airpocket-soundman/magfield-nodes/charge-board/README.md

# 充電ボード（ハブ）

ノード基板10台分の充電・監視・書き込みをまとめるボードです。KiCadファイル一式を追加済みですが、**まだ設計途中（WIP）で未発注**です。詳細は [DESIGN.md](DESIGN.md) を参照してください。

## ステータス（2026-10-30時点）

- 4層基板（100 × 96 mm）。現行ファイル（routed70）のDRCは、未接続1件（U2 TCA9535 の VCC）と CH6_STAT ビアのクリアランスエラー4件が残っています。
- U2周りの局部改版は試行済みですが、最良案は採用せず現行ファイルのままです。対処方針は DESIGN.md に記録しています。
- `wip/magfield-hub-u2rev19-WIP.kicad_pcb` は、そのU2改版の試行版（設計途中の作業ファイル）です。クリアランスエラーは0件まで解消しましたが、信号の未接続が6件残っており、現行ファイルには未反映です。

## 構成

- ホスト接続: M5Stack の Port A（Grove / I2C）。ボード自体にマイコンは載せない
- 充電チャンネル ×10: MCP73831（PROG抵抗で約40mA = LIR2032の1C）、チャンネルごとのカットオフ用MOSFETとステータスLED
- 制御・監視: TCA9535（I2C GPIOエクスパンダ）×2 でカットオフ制御とSTAT読み取り、74HC4067（アナログマルチプレクサ）+ ADS1115（I2C ADC）で全チャンネルの電池電圧を読み取り
  - 「充電を一瞬止めてから電圧を測る」ことで、80〜90%充電でのカットオフを電圧ベースで判定する
- 書き込み: UPDI入力を同様に切り替えて、選択したチャンネルのノードへ書き込み信号を送る
- 電源: 充電用5VはボードのUSB-C入力から（10ch合計約400mAのため、Port Aの5Vには頼らない）
- ノード接続: JST PH 4ピン ×10（1=GND / 2=VBAT充電 / 3=UPDI / 4=ID予備）— ノード基板側と同一の割り当て

## ファイル

- `magfield-hub.kicad_pro / .kicad_sch / .kicad_pcb` — KiCad 8 プロジェクト
- `DESIGN.md` — 設計仕様・判断記録・検証結果
- `hub-bom-jlcpcb.csv` / `hub-cpl-jlcpcb.csv` — JLCPCB PCBA用BOM・配置データ
- `gerbers/` — 製造用ガーバー（4層）
