airpocket-soundman/magfield-nodes/charge-board/DESIGN.md

# MAGFIELD HUB — M5Stack制御 10ch充電ボード 設計メモ

磁場可視化ノード（`../kicad/`、ノード基板v2 = JST PH 4pin仕様）の充電・書き込みハブ。
旧STM32ドック（`../kicad-dock/`）の後継で、頭脳は持たず、制御は Port A (Grove/I2C) で
接続した M5Stack が担う。チャンネル回路のレシピはドック設計を踏襲。

**状態: 100×96mm 版（2026-10-30 レイアウト変更＋仕上げ配線、同日に4層化して
プレーン接続化）。未接続は 23→**1項目**（U2.21 VCC のみ、下記「検証結果」に
理由と対処を明記）まで削減。DRC エラーは CH6_STAT ビア1箇所の4件のみ
（クリアランス 0.175mm／ホール 0.20mm、製造可能水準だがルール未達）。
U2.21 は改版か組立時のジャンパ配線で対処すること。それ以外は製造可能水準。**

## ファイル

- `magfield-hub.kicad_pro` / `.kicad_sch` / `.kicad_pcb`
- `maghub.pretty/` — 自作フットプリント（SJ3 ソルダージャンパ）
- `gerbers/` — ガーバー＋ドリル（ゾーン充填済みの最終基板から出力）
- `work/` — 生成スクリプト（design.py が回路の単一情報源、gen_sch.py / gen_pcb.py）、
  配線作業ファイル、`iterations/` — 基板画像

## 基板仕様

- **100 × 96 mm**（2026-10-30 に 118×58 から変更、JLCPCB 最安サイズ帯 ≤100×100 に収納）、
  **4層**、1.6mm想定、JLCPCB標準ルール（クリアランス 0.15mm）
  - 層構成: **F.Cu 信号 / In1.Cu = GND 全面プレーン / In2.Cu = 電源プレーン
    （5V_CHG と 5V_LOG に分割）/ B.Cu 信号**
  - 当初はコスト優先で2層に留めたが、2層では GND/電源ポケットが23項目
    未接続のまま解消できなかったため、2026-10-30 のユーザー判断で本基板のみ
    4層化した（ノード基板は2層のまま）。PROG 24kΩ ≈ 41.7mA の仕様は不変。
- 小型化方針: ノードコネクタは11.35mmピッチ一列では約114mm必要なため、上辺に5個
  （J1〜J5）・下辺に5個（J6〜J10、180°回転）の2列配置に変更。各チャンネルの部品は
  コネクタに隣接するブロックに集約し、制御ICは基板中央の帯（y≈40〜58）に集約して
  信号引き回しを短縮した。
- ゾーン（すべて充填済みで保存）:
  - GND: F.Cu / B.Cu 全面（優先度0）＋ **In1.Cu 全面プレーン（優先度0）**
  - 5V_CHG: B.Cu の上チャンネル領域（y 8.5〜41）＋下チャンネル領域（y 57.5〜88.5）
    ＋左端スパイン（x 2〜16、USB-C/SJ1/C90/C91用、優先度10）
  - 5V_LOG: F.Cu の中央帯（y 31〜61.5、優先度10）— プルアップ抵抗群と制御ICの直上に給電
  - 5V_LOG: B.Cu の中央帯（x 18〜98、y 42〜56.5、優先度10）— 制御ICの直下に給電
    — 制御IC群の直下に給電し、F帯とはビアで接続
  - **In2.Cu 電源プレーン（4層化で追加）**: 5V_CHG = 上/下チャンネル帯
    （y 8.5〜41 / 57.5〜88.5）＋左スパイン（x 2〜16、y 40〜57.5、優先度10）、
    5V_LOG = 中央帯（y 31〜61.5、優先度20で重なり部を優先）。両ネットは
    プレーン上でも分離を維持。浮いていた GND/5V ポケットはビアで各プレーンへ接続した。

## アーキテクチャ

```
M5Stack ──Port A (Grove, I2C 3.3V)── レベルシフト ── I2C (5V) ─┬─ TCA9535 #1 (0x20)
                                                                ├─ TCA9535 #2 (0x21)
                                                                └─ ADS1115 (0x48)
USB-C 5V ── 5V_CHG プレーン ── 10ch充電チャンネル ── JST PH ── ノード
                    └── SJ1（ソルダージャンパ）── 5V_LOG ── ロジック全般
```

- 本基板にメインMCUは無い。全ての制御・計測はM5Stack上のプログラムが行う。
- 充電電力（10ch合計 約400mA）は Port A の5Vに依存せず **USB-C入力** から取る
  （Port A の5V供給能力はM5Stackの機種依存のため）。
- ロジック電源 5V_LOG は SJ1（3パッド・ソルダージャンパ）で選択:
  **デフォルト = 5V_CHG側（USB-C）**、代替 = Grove 5V (GRV_5V)。
  ジャンパ未接続（オープン）だとロジックは無電源になるので、必ずどちらかにブリッジする。
- I2Cレベルシフト: M5Stack Port A は 3.3V ロジック（5Vトレラントでない）ため、
  BSS138 ×2 の定番シフタを入れた。LV側プルアップ(10kΩ)用の 3.3V は
  XC6206P332MR (U91) で 5V_LOG から生成（このLDOの負荷はプルアップのみ）。
  HV側プルアップは 4.7kΩ → 5V_LOG。

## チャンネル回路（×10、ドック設計と同一レシピ）

部品番号は ch n に対して: 受け Jn (J1〜J10)、充電IC U(10+n)、PMOS Q(10+n)、
NMOS Q(20+n)、LED Dn、抵抗は R(100+(n−1)×10 + k) の規則（下表）。

| 役割 | 部品 | 値/型番 | 接続 |
|---|---|---|---|
| ノード接続 | J1〜J10 | JST B4B-PH-K-S | 1=GND, 2=VBAT, 3=UPDI, 4=ID/NC（ノードv2と一致） |
| 充電IC | U11〜U20 | MCP73831T-2ACI/OT (SOT-23-5) | 1=STAT, 2=VSS, 3=VBAT, 4=VDD(5V_CHG), 5=PROG |
| PROG抵抗 | R+1 | 24kΩ | I = 1000/Rprog(kΩ) ≈ 41.7mA ≒ LIR2032の1C（24.9kはBasicでないため24kに変更） |
| 入力容量 | C(50+n) | 4.7µF | 5V_CHG−GND |
| 電池側容量 | C(70+n) | 4.7µF | CHn_BAT−GND |
| カットオフ PMOS | Q(10+n) | AO3401A | S=充電IC側(CHn_CHG), D=ノード側(CHn_BAT) |
| ゲートプルアップ | R+2 | 100kΩ | CHn_BAT − CHn_GATE |
| ゲート駆動 NMOS | Q(20+n) | 2N7002 | ゲート=CHn_EN |
| ENプルアップ | R+3 | 100kΩ | 5V_LOG − CHn_EN |
| STATプルアップ | R+4 | 47kΩ | 5V_LOG − CHn_STAT |
| 状態LED抵抗 | R+5 | 1kΩ | 5V_CHG − LEDアノード |
| 状態LED | D1〜D10 | 0603 赤 | カソード=CHn_STAT（STATがLow=充電中に点灯） |
| VBAT分圧 上 | R+6 | 330kΩ | CHn_BAT − CHn_VSENSE |
| VBAT分圧 下 | R+7 | 330kΩ | CHn_VSENSE − GND |

### カットオフの動作（デフォルトON）

- CHn_EN は 100kΩ で 5V_LOG にプルアップされているため、**電源投入時・エクスパンダ
  未初期化時（TCA9535は電源投入時 全ポート入力=Hi-Z）でも EN=High → NMOS ON →
  PMOS ON → 充電が進む**。過充電側の安全は充電ICの4.2V終止が担保する。
- 止めるときはホストが該当ENを出力・Lowにする（「CHn_ENは充電許可、アクティブHigh」）。

### STATの読み取り（デジタル）

MCP73831 の STAT はオープンドレイン/3ステート。47kΩプルアップでエクスパンダの
入力として読む:

| STAT | 読み | 意味 |
|---|---|---|
| Low | 0 | 充電中 |
| Hi-Z → プルアップで High | 1 | 充電完了 または ノード未接続/異常（VBAT計測で判別可能） |

## 制御部品と I2C アドレスマップ

| デバイス | 型番 | I2Cアドレス | 役割 |
|---|---|---|---|
| U2 TCA9535RTWR #1 | WQFN-24 | **0x20**（A2=A1=A0=GND） | EN1–8（出力）、STAT1–8（入力） |
| U3 TCA9535RTWR #2 | WQFN-24 | **0x21**（A0=5V_LOG, A1=A2=GND） | EN9–10、MUX選択、UPDI有効化、STAT9–10 |
| U4 ADS1115IDGSR | VSSOP-10 | **0x48**（ADDR=GND） | VBAT計測（AIN0のみ使用、AIN1–3=GND） |

- INT出力は本基板では未接続（Grove 4pinに線が無い）。ホストはポーリングで読む。
- TCA9535 の電源投入時デフォルトは全ポート入力。ホスト初期化手順は後述。

### エクスパンダ ピンマップ（全ピン）

U2 (0x20):

| ピン名 | 機能 | ピン名 | 機能 |
|---|---|---|---|
| P00–P07 | CH1–CH8_EN（出力に設定） | P10–P17 | CH1–CH8_STAT（入力のまま） |

U3 (0x21):

| ピン名 | 機能 | ピン名 | 機能 |
|---|---|---|---|
| P00 | CH9_EN（出力） | P10 | CH9_STAT（入力） |
| P01 | CH10_EN（出力） | P11 | CH10_STAT（入力） |
| P02 | MUX_S0（出力） | P12–P17 | 予備（未接続） |
| P03 | MUX_S1（出力） | P07 | 予備（未接続） |
| P04 | MUX_S2（出力） | | |
| P05 | MUX_S3（出力） | | |
| P06 | UPDI_EN（出力、アクティブLow） | | |

- MUX_S0–S3 は基板上で 100kΩ プルダウン（R201–R204）付き。エクスパンダ未初期化時は
  両マルチプレクサとも ch1（Y0）を指すが、UPDI側は UPDI_EN のプルアップで無効化
  されているため実害はない。
- UPDI_EN は基板上で 100kΩ プルアップ（R97）→ 電源投入時は無効（安全側）。

## VBAT計測（74HC4067 #1 + ADS1115）

- 各チャンネルの CHn_BAT を 330k/330k で 1/2 に分圧し、U5 (74HC4067) の
  Y0–Y9 に入力。共通端子 Z → ADS1115 AIN0（100nF の平滑容量 C99 付き）。
- 換算: **VBAT = 2 × V(AIN0)**。ADS1115 は PGA = ±4.096V 設定を推奨
  （LSB = 125µV → VBAT分解能 0.25mV）。
- 分圧抵抗はノード接続中だけ電池から約 4.2V/660kΩ ≈ **6.4µA** を消費する。
  充電電流40mAに対して無視でき、計測ポーズ（秒オーダー）でも問題にならない。
- マルチプレクサ選択表（両MUX共通、UPDI側も同じチャンネルが選ばれる）:

| S3 S2 S1 S0 | 選択チャンネル | | S3 S2 S1 S0 | 選択チャンネル |
|---|---|---|---|---|
| 0 0 0 0 | ch1 (Y0) | | 0 1 0 1 | ch6 (Y5) |
| 0 0 0 1 | ch2 (Y1) | | 0 1 1 0 | ch7 (Y6) |
| 0 0 1 0 | ch3 (Y2) | | 0 1 1 1 | ch8 (Y7) |
| 0 0 1 1 | ch4 (Y3) | | 1 0 0 0 | ch9 (Y8) |
| 0 1 0 0 | ch5 (Y4) | | 1 0 0 1 | ch10 (Y9) |

  S=1010〜1111 は Y10–Y15（未接続）を指す。ホストは使わないこと。

## UPDIルーティング（74HC4067 #2）

- 外部のUPDIソース（M5Stackの別ポートやUSB-UARTアダプタ等、本基板の範囲外）を
  **J12 UPDI_IN**（JST B3B-PH-K-S、3pin: 1=UPDI_SRC, 2=GND, 3=NC/将来の対象電源用）に接続する。
- U6 の Z = UPDI_SRC、Y0–Y9 = 各チャンネルの UPDI（ノードコネクタ pin3）。
  選択は U5 と共通の MUX_S0–S3（上表）。
- U6 の /E は UPDI_EN（U3 P06、アクティブLow）: ホストが Low を書いたときだけ
  選択中チャンネルに UPDI がつながる。それ以外は全チャンネル絶縁。
- 注意: 74HC4067 のオン抵抗（約80Ω）は SerialUPDI 系の抵抗ネットワークと
  直列に入る。書き込み側の抵抗値は実機で調整すること（TODO参照）。

## ホスト（M5Stack）プログラムの想定動作

初期化:
1. U2/U3 の Configuration レジスタで EN・MUX_S・UPDI_EN のピンを出力に設定
   （U2: Port0=出力, Port1=入力。U3: Port0=出力, Port1=入力）。
   出力ラッチは初期化前に「EN=全High（充電許可）、UPDI_EN=High（無効）」を
   先に書いてから出力有効化すると、初期化中の中断がない。
2. ADS1115 を単発/連続変換、PGA ±4.096V、AIN0 測定に設定。

充電ループ（80〜90%カットオフ）:
1. STAT をポーリング。Low のチャンネルが充電中。
2. 定期的に（例: 各ch 数十秒おき）**計測ポーズ**: 該当chの EN を Low（充電停止）
   → MUX_S をそのchに合わせる → 数百ms待って電池電圧が落ち着くのを待つ
   → ADS1115 で読む → VBAT = 2×読み値 → EN を High に戻して充電再開。
   充電中の端子電圧は電流で高めに出るため、この「止めて測る」が必須。
3. 目標電圧（LIR2032 で 80〜90% ≒ 約3.95〜4.05V、実測で詰める）に達したら
   EN を Low のままにしてそのchを終了。STAT が High になれば充電IC側の
   満充電終止（4.2V）に到達した合図としても使える。
4. STAT=High かつ VBAT が低い場合はノード未接続/異常と判断できる。

UPDI書き込み:
1. 対象chの EN はどちらでもよい（ノード側は自電池で動作する前提）。
2. MUX_S に対象ch番号を設定 → UPDI_EN を Low → 外部UPDIソースから書き込み
   → 終了後 UPDI_EN を High に戻す。同時に書けるのは1台のみ。

## BOM（全点 LCSC 在庫＋JLCPCB SMT実装可を確認済み、2026-10-30）

全点について LCSC の具体番号と JLCPCB の部品クラス（Basic/Preferred/Extended）を確認済み。
番号の無い部品は SJ1（ソルダージャンパ、購入部品ではない）のみ。

| 数量 | 部品 | 型番 | LCSC | JLCPCBクラス |
|---|---|---|---|---|
| 2 | エクスパンダ U2/U3 | TCA9535RTWR (WQFN-24) | C129354 | Extended |
| 10 | 充電IC U11–U20 | MCP73831T-2ACI/OT | C424093 | Extended |
| 1 | ADC U4 | ADS1115IDGSR | C37593 | Extended |
| 2 | マルチプレクサ U5/U6 | 74HC4067PW,118 | C179326 | Extended |
| 10 | PMOS Q11–Q20 | AO3401A | C15127 | **Basic** |
| 10 | NMOS Q21–Q30 | 2N7002 | C8545 | **Basic** |
| 2 | レベルシフト Q91/Q92 | BSS138-7-F (Diodes) | C40912 | Extended |
| 1 | LDO U91 | XC6206P332MR-G | C5446 | **Basic** |
| 1 | USB-C J13 | HRO TYPE-C-31-M-12 | C165948 | Extended |
| 11 | ノード/Grove J1–J11 | JST B4B-PH-K-S (THT実装) | C131334 | Extended |
| 1 | UPDI入力 J12 | JST B3B-PH-K-S (THT実装) | C131339 | Extended |
| 10 | LED D1–D10 | KT-0603R 赤 | C2286 | **Basic** |
| 20 | 抵抗 100kΩ 0603 | UniOhm 0603WAF1003T5E 系 | C25803 | **Basic** |
| 3 | 抵抗 10kΩ 0603 | 同上 10k | C25804 | **Basic** |
| 2 | 抵抗 4.7kΩ 0603 | 同上 4.7k | C23162 | **Basic** |
| 10 | 抵抗 47kΩ 0603 | 同上 47k | C25819 | **Basic** |
| 10 | 抵抗 1kΩ 0603 | 同上 1k | C21190 | **Basic** |
| 2 | 抵抗 5.1kΩ 0603 | 同上 5.1k | C23186 | **Basic** |
| 20 | 抵抗 330kΩ 0603 | 同上 330k | C23137 | **Basic** |
| 10 | 抵抗 24kΩ 0603 (PROG) | 同上 24k | C23352 | **Basic** |
| 多数 | コンデンサ 100nF 0603 | CC0603KRX7R9BB104 | C14663 | **Basic** |
| 20 | コンデンサ 4.7µF 0603 | CL10A475KO8NNNC | C19666 | **Basic** |
| 2 | コンデンサ 1µF 0603 | CL10A105KB8NNNC | C15849 | **Basic** |
| 1 | コンデンサ 47µF 0805 (C90) | CL21A476MQYNNNE (6.3V X5R) | C16780 | **Basic** |

注記:
- 47µF (C90) は 6.3V 定格 X5R を 5V で使うため DC バイアスで実効容量が大きく低下する
  （目安として半分以下）。USB-C 入力のバルク用途としては許容範囲だが、余裕を見たい場合は
  耐圧の高い部品への変更を検討すること。
- BSS138 は onsemi 版 (C52895) でなく在庫の厚い Diodes 版 C40912 を採用（SOT-23 G/S/D 同一）。
- JST PH コネクタは JLCPCB では THT 実装扱い（スルーホール工程）。

## 検証結果（2026-10-30、最終基板 magfield-hub.kicad_pcb）

- 回路図: 173部品 / 108ネット。design.py のネットリストと全ピン照合済み。ERC 0エラー。
- 仕上げ配線（2026-10-30）で完了した項目:
  - **実パッド5個は全て接続済み**: U13.4 / U14.4（チャージャ VDD、チャンネル
    フィード鎖を B面フィールドへ縫合）、J13 VBUS（A4/B9 は F面トラック→
    (9.80,50.30) ビアで B面 5V_CHG フィールドへ、A9/B4 は (2.15,45.62)
    ビアで同フィールドへ）、U2.15 CH6_STAT（パッド列 y49.25 を東進→
    (47.15,49.25) ビア→B面を西〜南へ回し CH6 ビア (12.24,64.43) へ到達。
    CH7 エスケープ直線化・CH5 エスケープ y49.52 への沈下でクリアランス確保）。
  - **J11/R154 コートヤード重なり解消**: R154 を +0.8mm 東 (9.7,63.4) へ移動し
    両ネットを再配線。
  - 南側チャンネル給電の 0.25mm フィルネック切れ 4件（x=35/54/73/92、
    y74.4–75.3）を F面トラックで橋渡し。
  - 5V_LOG ビア同士の hole_near_hole（(32.12,59.12) と (31.88,58.88)、
    中心間 0.34mm）を後者のジャンクションを (31.50,58.40) へ移設して解消。
- **4層化（2026-10-30、ユーザー判断）で旧23ポケットのうち22を解消**:
  In1.Cu に GND 全面プレーン、In2.Cu に 5V_CHG／5V_LOG 分割プレーンを新設し、
  浮いていたポケットを全てビアでプレーンへ接続した。解消した内訳:
  U2/U3 の TCA9535 GND ポケット（EP含む）、U5/U6 74HC4067 の GND・/E、
  U4 ADS1115 の ADDR/GND、U3.18/U3.21、5V_CHG の ch1/5/7/10 ポケット
  （入力コンデンサ＋PROG抵抗）と U15.4、5V_LOG スリバー群
  （R183.1 / R96.1 / C96.1 / U5.24）、ch7/ch9 チャージャ GND、
  R177.2（ch8 STAT プルダウン）、**R123.1**（CH3_EN プルアップ、
  4層化後のフィル断片解析で新規発見しその場で接続）。
  パッド無し GND フィル断片5件中2件も In1 へ接続（残り3件はコネクタ
  PTH ドリル近接／UPDI 配線と干渉するため見送り。パッド無しの死に銅箔で実害なし）。
- PCB DRC（KiCad 8.0.9 CLI、最終版）: **未接続 1項目**、**エラー 4件**。
  - 未接続1件: **U2.21（TCA9535#1 の VCC、5V_LOG）**。パッド北側が
    SCL/SDA エスケープの編み目（45°対角線2本）・ピン22（NC）の角・EP に
    四方を封鎖され、F面スタブ＋ビア（基板設定 min 0.5/0.3）の合法配置が
    存在しない（複数箇所で 0.03〜0.06mm 不足を実測確認）。
    対処: 改版時に ①VCC エスケープを I2C エスケープより先に引く、
    ②I2C 西側入口を B面経由にする、③U2 を東へ ≥0.3mm 移動、のいずれか。
    当面は組立時に U2.21 → C94.1（U2 の 5V_LOG デカップリング、
    (44.23,43.50)）へ細線ジャンパを渡せば動作可能。
  - エラー4件: 全て CH6_STAT ビア (47.15,49.25) の1箇所に集中（2層時代の
    5件から1件減）:
    - clearance 2件: 対 CH5 エスケープ 0.175mm / 対 CH7 エスケープ
      0.175mm（ルール 0.2mm）。
    - hole_clearance 2件: 対 U2.14 / U2.16 パッド 0.20mm（ルール 0.25mm）。
    - ビアの移動（東は CH5 のダイプ配線と CH7 の横走行、南北はパッド列が
      封鎖）も、ビア縮小（基板設定で min 径0.5／ドリル0.3）も不可と確認済み。
      STAT 信号同士の近接であり機能影響は無く、製造自体は可能
      （組立時のブリッジ注意）。改版時は CH6_STAT を B面先行エスケープに
      変更して解消すること。
  - 警告のみ: silk_overlap 58 / via_dangling 22 / silk_over_copper 2 /
    holes_co_located 2 / silk_edge_clearance 1 / track_dangling 1
    （via_dangling はプレーン着地ビアに対する警告、holes_co_located は
    PTH パッド上の再構築ビアで、いずれも意図した構造）。
- ~~残る未接続 23項目のポケット一覧と旧対処~~ → 4層化で解消済み。
  唯一残る U2.21 と CH6_STAT ビアの扱いは上記 DRC の項を参照。
- 出力ファイル（4層最終版から再生成済み）: `gerbers/` 一式
  （In1_Cu.g2 / In2_Cu.g3 を含む4層セット＋ドリル）＋ `hub-gerbers.zip`、
  `hub-bom-jlcpcb.csv`（26行/173点、SJ1 のみ LCSC 無し=半田ジャンパ、
  部品変更なしのため据え置き）、
  `hub-cpl-jlcpcb.csv`（173点、同据え置き）、`iterations/final-front.svg` /
  `final-back.svg`。

## リスクとTODO（製造前）

0. ~~**残ポケット23項目の手仕上げ**~~ → **4層化で解決済み（2026-10-30）**。
   残件は U2.21（VCC、未接続1件）と CH6_STAT ビアの DRC 4件のみ。
   発注前にどちらでいくか決めること: (a) このまま発注し U2.21 は組立時に
   ジャンパ配線＋CH6 はブリッジ注意、(b) U2 周りだけ改版してから発注。
1. **Groveピン順の実物照合** — J11 は M5Stack Port A の想定ピン順
   （1=GND, 2=5V, 3=SDA, 4=SCL）。実ケーブルで照合すること。
2. **USB-Cフットプリントの向き確認** — TYPE-C-31-M-12 (C165948) のパッド並びと実装向き。
3. **UPDI実機確認** — 74HC4067 経由のUPDI通信（オン抵抗・信号波形）と、
   外部ソース側の直列抵抗の最適値を実機で確認すること。
4. **80〜90%の電圧目安** — LIR2032 の実測充電カーブで目標電圧を詰めること
   （容量の個体差・温度で変動する）。
5. **SJ1 のデフォルトブリッジ** — 製造時に 5V_CHG側をブリッジするか、
   組立後の手はんだで対応するか決めること（オープンだとロジック無電源）。
6. 充電中のノード抜き差し（活線挿抜）に対する保護は充電IC内蔵機能のみ。
