airpocket-soundman/magfield-nodes/node/iterations/final4-back.png

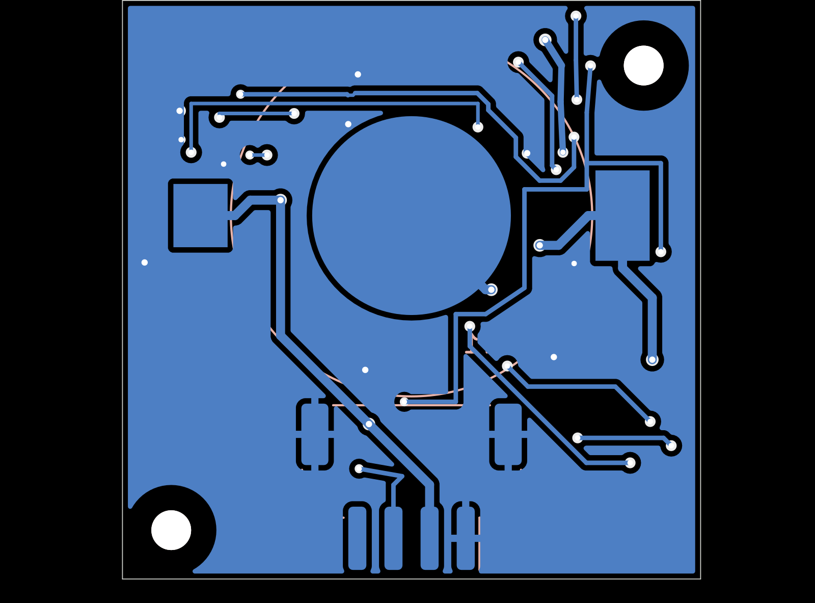
node/iterations/final4-back.png
