airpocket-soundman/magfield-nodes/node/iterations/final4-front.png

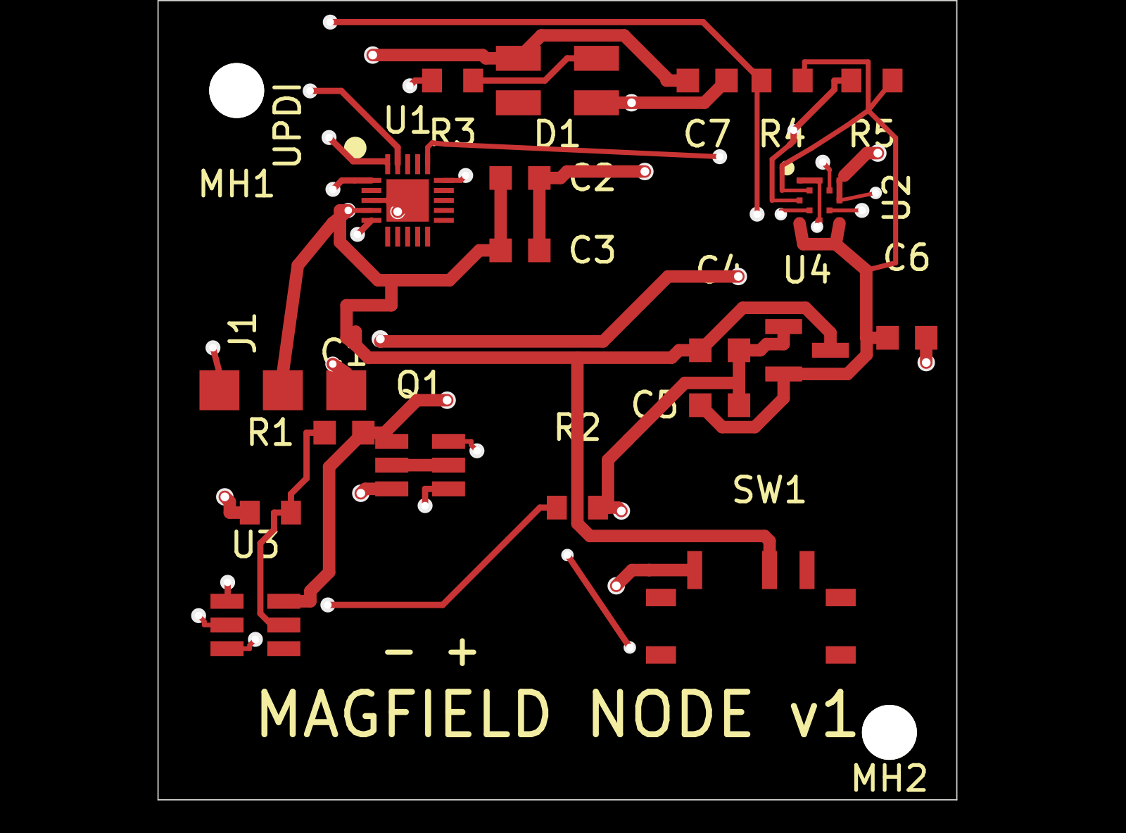
node/iterations/final4-front.png
