airpocket-soundman/magfield-nodes/bom-estimate.md

# 磁場可視化ノード基板 — 部品代見積もり (BOM Estimate)

作成: 2026-10-29 / 価格ソース: 主に LCSC (lcsc.com)、数量ティアは約100個
換算レート: **$1 = ¥155**（前提）
前提: 充電接点は基板上の金パッドで済ませ、部品コストはゼロとする。充電回路はドック側（このBOMに含めない）。

## BOM表（1枚あたり、約100個購入時）

| 役割 | 採用部品 | LCSC品番 | 単価 @~100 (USD) | 価格ソース |
|---|---|---|---|---|
| 電池 | LIR2032 充電式コインセル 3.6V 40mAh ※LCSC取扱なし（2026-10-30にLCSC再確認、本体掲載なし） | — | $1.26（PowerStream 100〜999個価格）／ **AliExpress実勢 約¥74/個（100個≈¥7,400、送料込）** | PowerStream https://www.powerstream.com/licoin.htm ／ AliExpress Digital Dragon Store 50個¥3,703×2+送料（2026-10-30確認、表示整合性が最も良い）https://ja.aliexpress.com/item/1005009786099531.html 。最安はMeitu A Store 100個¥7,366だが型番表記ゆれあり |
| 電池ホルダー | MYOUNG MY-2032-10（CR/LIR/ML2032対応・SMTリフロー可） | C964827 | $0.0845（50+ティア） | https://www.lcsc.com/product-detail/Battery-Connectors_MYOUNG_C964827.html |
| MCU（本命） | Microchip ATtiny1616-MNR（QFN-20、1.8〜5.5V動作、I2C/PWMあり） | C507118 | $0.6081（100+ティア、在庫8,367） | https://www.lcsc.com/product-detail/microcontrollers-mcu-mpu-soc_microchip-tech-attiny1616-mnr_C507118.html |
| 地磁気センサー（本命） | Bosch BMM150（3軸、I2C、1.62〜3.6V、WLCSP-12） | C171681 | $0.6933（LCSC製品ページ表示価格、在庫あり） | https://www.lcsc.com/product-detail/3d-magnetic-sensors_bosch-sensortec-bmm150_C171681.html |
| RGB LED | Worldsemi WS2812B-MINI-V3/W（3535、アドレスブル、単線制御） | C527089 | $0.0509（LCSC製品ページ表示価格、在庫あり） | https://www.lcsc.com/product-detail/Light-Emitting-Diodes-LED_Worldsemi-WS2812B-MINI-V3-W_C527089.html |
| 保護IC | DW01A（KUU、SOT-23-6） | C42459937 | $0.0237（20+ティア、在庫10,400） | https://www.lcsc.com/product-detail/C42459937.html |
| 保護MOSFET | FS8205A（TECH PUBLIC、SOT-23-6、デュアルNch） | C2830320 | $0.0256（LCSC製品ページ表示価格、在庫あり） | https://www.lcsc.com/product-detail/C2830320.html |
| LDO（センサー電源） | Torex XC6206P302MR-G（3.0V、SOT-23）※2026-10-30標準化で確定 | C9972 | $0.0863（LCSC製品ページ表示価格、在庫あり。JLCPCB SMT実装ライブラリにも在庫あり） | https://www.lcsc.com/product-detail/C9972.html |
| 電源スイッチ | SHOU HAN MSK12C02（SPDTスライドスイッチ SMD）※2026-10-30標準化で確定（旧C16168はLCSC掲載終了、現行はC431540） | C431540 | $0.046（100+ティア、在庫あり。JLCPCB SMT実装ライブラリにも在庫あり） | https://www.lcsc.com/product-detail/C431540.html |
| パッシブ一式 | デカップリング、I2Cプルアップ、保護回路のR/C等 11点 ※2026-10-30標準化で全て具体品番化：100nF Samsung C1591×4、10µF C19702、1µF C15849×2、100Ω C22775、1k C21190、300Ω C23025、4.7k C23162×2（抵抗4種と10µF/1µFはJLCPCB Basic部品） | 上記参照 | $0.05（実品番の単価積み上げ ≈$0.0496） | 各LCSC製品ページ（2026-10-30在庫確認済み） |
| 基板 | JLCPCB 2層 25×25mm相当、100枚（2026-10-29オンライン見積もりで実価格確認） | — | $0.152/枚（100枚で$15.20、送料別）。送料$26.77込みだと約$0.42/枚 | JLCPCB見積もりページ https://cart.jlcpcb.com/quote |

### 候補比較（採用しなかったもの）

- **MCU次点: Nordic nRF52810-QCAA-R** — LCSC 100+ティア **$1.5470**（Findchips経由でLCSC価格を確認、在庫857）。BLEが要るなら有力だが、①約2.5倍の価格、②動作上限3.6Vで満充電4.2VのLIR2032に直結できない。ATtiny1616は5.5Vまで対応し電池直結できるのが決め手。 https://www.findchips.com/search/NRF52810-QCAA-R
- **地磁気センサーの安価な代替: QMC5883L** — 裸チップ相場 約$0.55（Alibaba出品で確認、MOQ 5）。ただし今回の調査では **LCSCのチップ単体ページを確認できなかった**（モジュール品のみ）。LCSC/JLCPCBライブラリで在庫が確認できればBMM150から約$0.14/枚下げられる。 https://www.accio.com/plp/ist8310-vs-qmc5883l
- **LIS3MDL（ST）** — DigiKeyで「Obsolete」表示、ST公式ストアでも在庫切れのため不採用。 https://www.digikey.com/en/products/detail/stmicroelectronics/LIS3MDLTR/4309733
- **ICM-20948 / BMM350** — 今回は価格未確認（9軸はオーバースペック気味）。

## 合計

| 項目 | USD | JPY（$1=¥155） |
|---|---|---|
| 部品のみ 1枚あたり | **$2.93** | **約¥454** |
| 部品＋基板 1枚あたり | 約$3.08 | 約¥477 |
| 部品のみ 100枚分 | **$292.84** | **約¥45,400** |
| 部品＋基板 100枚分 | 約$308.04 | 約¥47,700 |
| （参考）基板を送料込みで按分すると1枚あたり | 約$3.35 | 約¥519 |

※2026-10-30の部品標準化で更新：従来は推定だったスイッチを実品番（C431540、$0.046）に置換し、見積もり表に入っていなかったLDO（C9972、$0.0863）を追加したため、旧合計（$2.83/枚）から +$0.10/枚。

※送料、JLCPCBの実装費（SMT Assembly）、ドック側充電システムは含まない。

## メモ

### コストの支配要素
1. **電池（LIR2032）$1.26 が全体の約45%**。次いで地磁気センサー $0.69、MCU $0.61。この3点で9割近い。
2. 保護回路一式（DW01A＋FS8205A＋周辺）は合計でも約$0.07と誤差レベル。全基板に入れても問題なし。
3. LED・ホルダー・スイッチ・パッシブは各$0.03〜0.08と安い。

### 節約できるところ
- センサーを QMC5883L にできれば −$0.14/枚程度（ただしLCSC在庫の要確認）。
- 電池は購入先で大きく変わる（Alibaba系では $0.65〜1.50 のレンジ表示あり）。100個規模なら相見積もりの価値あり。
- MCUを ATtiny1614/814 等の下位グレードにする手もあるが、節約幅は小さい。

### 重要な設計上の注意（コストより先に潰すべき点）
- **電圧の上限問題**: BMM150（および次点のnRF52810、QMC5883Lも）の絶対最大は **3.6V**。LIR2032は満充電で **4.2V** になるため、このままでは電池直結できない。対策のどれかが必要:
  - 小型LDOを1個追加（実施済み：Torex XC6206P302MR-G 3.0V、C9972、$0.0863。BMM150専用レールとして設計に組込済み）
  - 充電をドック側で約3.9〜4.0V止まりに抑える（それでも3.6Vは超えるので単独対策にはならない）
  - センサー電源だけダイオードでドロップする等の工夫
  - MCUのATtiny1616自体は5.5VまでOKなので影響なし。
- **WS2812B-MINI の下限電圧**: 定格は概ね3.5V〜。CR2032終止（約2.7〜3.0V）や電池電圧低下時に色・輝度が不安定になりうる（先の会話で出ていた「青が先に暗くなる」件）。LIR2032運用（3.0〜4.2V）なら実用範囲だが、低電圧時の挙動は要実測。
- **BMM150はWLCSP（BGA）パッケージ**。JLCPCB実装なら問題ないが、手はんだ・リワークは困難。試作フェーズではQMC5883L（LGA）やモジュールで検証してから本番投入が安全。

### 未検証・推定として扱った項目（正直メモ）
- LIR2032: LCSCに取扱が見つからなかったため PowerStream の数量価格を採用（LCSC価格ではない）。
- スライドスイッチとLDOは2026-10-30の標準化で実品番・実価格に確定済み（スイッチ C431540 $0.046 @100、LDO C9972 $0.0863）。パッシブ一式も全て具体品番化され、積み上げ ≈$0.0496 で従来推定 $0.05 と一致した。全品番のLCSC在庫とJLCPCB SMT実装ライブラリ在庫を2026-10-30に確認済み（詳細は kicad/DESIGN.md の標準化BOM表）。
- 基板: 2026-10-29にJLCPCBオンライン見積もりで実価格を確認済み（25×25mm・2層・100枚で$15.20、送料$26.77は別）。当初推定$0.30/枚は実価格$0.152/枚に更新した。
- BMM150 $0.6933 と WS2812B-MINI $0.0509 はLCSC製品ページの表示価格（JSON-LD）。100個ティアちょうどの価格とは限らないため、±数セント〜の誤差がありうる。BMM150についてはLCSC内の別スニペットで $1.5794 の表示も見られたため、実発注時にティア価格の再確認を推奨。
