airpocket-soundman/magfield-nodes/charge-board/hub-bom-jlcpcb.csv

Comment | Designator | Footprint | LCSC Part # | Quantity
4.7uF | C51,C52,C53,C54,C55,C56,C57,C58,C59,C60,C71,C72,C73,C74,C75,C76,C77,C78,C79,C80 | C_0603_1608Metric | C19666 | 20
47uF | C90 | C_0805_2012Metric | C16780 | 1
100nF | C91,C94,C95,C96,C97,C98,C99 | C_0603_1608Metric | C14663 | 7
1uF | C92,C93 | C_0603_1608Metric | C15849 | 2
RED | D1,D2,D3,D4,D5,D6,D7,D8,D9,D10 | LED_0603_1608Metric | C2286 | 10
B4B-PH-K-S | J1,J2,J3,J4,J5,J6,J7,J8,J9,J10 | JST_PH_B4B-PH-K_1x04_P2.00mm_Vertical | C131334 | 10
GROVE-PORTA | J11 | JST_PH_B4B-PH-K_1x04_P2.00mm_Vertical | C131334 | 1
B3B-PH-K-S | J12 | JST_PH_B3B-PH-K_1x03_P2.00mm_Vertical | C131339 | 1
TYPE-C-31-M-12 | J13 | USB_C_Receptacle_HRO_TYPE-C-31-M-12 | C165948 | 1
AO3401A | Q11,Q12,Q13,Q14,Q15,Q16,Q17,Q18,Q19,Q20 | SOT-23 | C15127 | 10
2N7002 | Q21,Q22,Q23,Q24,Q25,Q26,Q27,Q28,Q29,Q30 | SOT-23 | C8545 | 10
BSS138-7-F | Q91,Q92 | SOT-23 | C40912 | 2
5.1k | R91,R92 | R_0603_1608Metric | C23186 | 2
10k | R93,R94 | R_0603_1608Metric | C25804 | 2
4.7k | R95,R96 | R_0603_1608Metric | C23162 | 2
100k | R97,R102,R103,R112,R113,R122,R123,R132,R133,R142,R143,R152,R153,R162,R163,R172,R173,R182,R183,R192,R193,R201,R202,R203,R204 | R_0603_1608Metric | C25803 | 25
24k | R101,R111,R121,R131,R141,R151,R161,R171,R181,R191 | R_0603_1608Metric | C23352 | 10
47k | R104,R114,R124,R134,R144,R154,R164,R174,R184,R194 | R_0603_1608Metric | C25819 | 10
1k | R105,R115,R125,R135,R145,R155,R165,R175,R185,R195 | R_0603_1608Metric | C21190 | 10
330k | R106,R107,R116,R117,R126,R127,R136,R137,R146,R147,R156,R157,R166,R167,R176,R177,R186,R187,R196,R197 | R_0603_1608Metric | C23137 | 20
PWR_SEL | SJ1 | SJ3 |  | 1
TCA9535RTWR | U2,U3 | WQFN-24-1EP_4x4mm_P0.5mm_EP2.45x2.45mm | C129354 | 2
ADS1115IDGSR | U4 | VSSOP-10_3x3mm_P0.5mm | C37593 | 1
74HC4067PW | U5,U6 | TSSOP-24_4.4x7.8mm_P0.65mm | C179326 | 2
MCP73831T-2ACI/OT | U11,U12,U13,U14,U15,U16,U17,U18,U19,U20 | SOT-23-5 | C424093 | 10
XC6206P332MR | U91 | SOT-23 | C5446 | 1
