airpocket-soundman/magfield-nodes/node/quote/node-bom-jlcpcb.csv

Comment | Designator | Footprint | LCSC Part # | Quantity
MY-2032-10 battery holder for LIR2032 (cell NOT included) | BT1 | MY-2032-10 | C964827 | 1
100nF | C1,C2,C6,C7 | C_0603_1608Metric | C1591 | 4
10uF | C3 | C_0603_1608Metric | C19702 | 1
1uF | C4,C5 | C_0603_1608Metric | C15849 | 2
WS2812B-MINI-V3/W | D1 | WS2812B-MINI | C527089 | 1
S4B-PH-SM4-TB | J2 | JST_PH_S4B-PH-SM4-TB_1x04-1MP_P2.00mm_Horizontal | C265102 | 1
FS8205A | Q1 | SOT-23-6 | C2830320 | 1
100R | R1 | R_0603_1608Metric | C22775 | 1
1k | R2 | R_0603_1608Metric | C21190 | 1
300R | R3 | R_0603_1608Metric | C23025 | 1
4.7k | R4,R5 | R_0603_1608Metric | C23162 | 2
MSK12C02 SPDT slide switch (SHOU HAN) | SW1 | SW_MSK12C02 | C431540 | 1
ATtiny1616-MNR | U1 | VQFN-20-1EP_3x3mm_P0.4mm_EP1.7x1.7mm | C507118 | 1
BMM150 | U2 | BMM150_WLCSP12 | C171681 | 1
DW01A | U3 | SOT-23-6 | C42459937 | 1
XC6206P302MR-G | U4 | SOT-23 | C9972 | 1
