airpocket-soundman/magfield-nodes/node/magfield-node.kicad_pcb

## KiCad design node/magfield-node.kicad_pcb (2026-10-30)

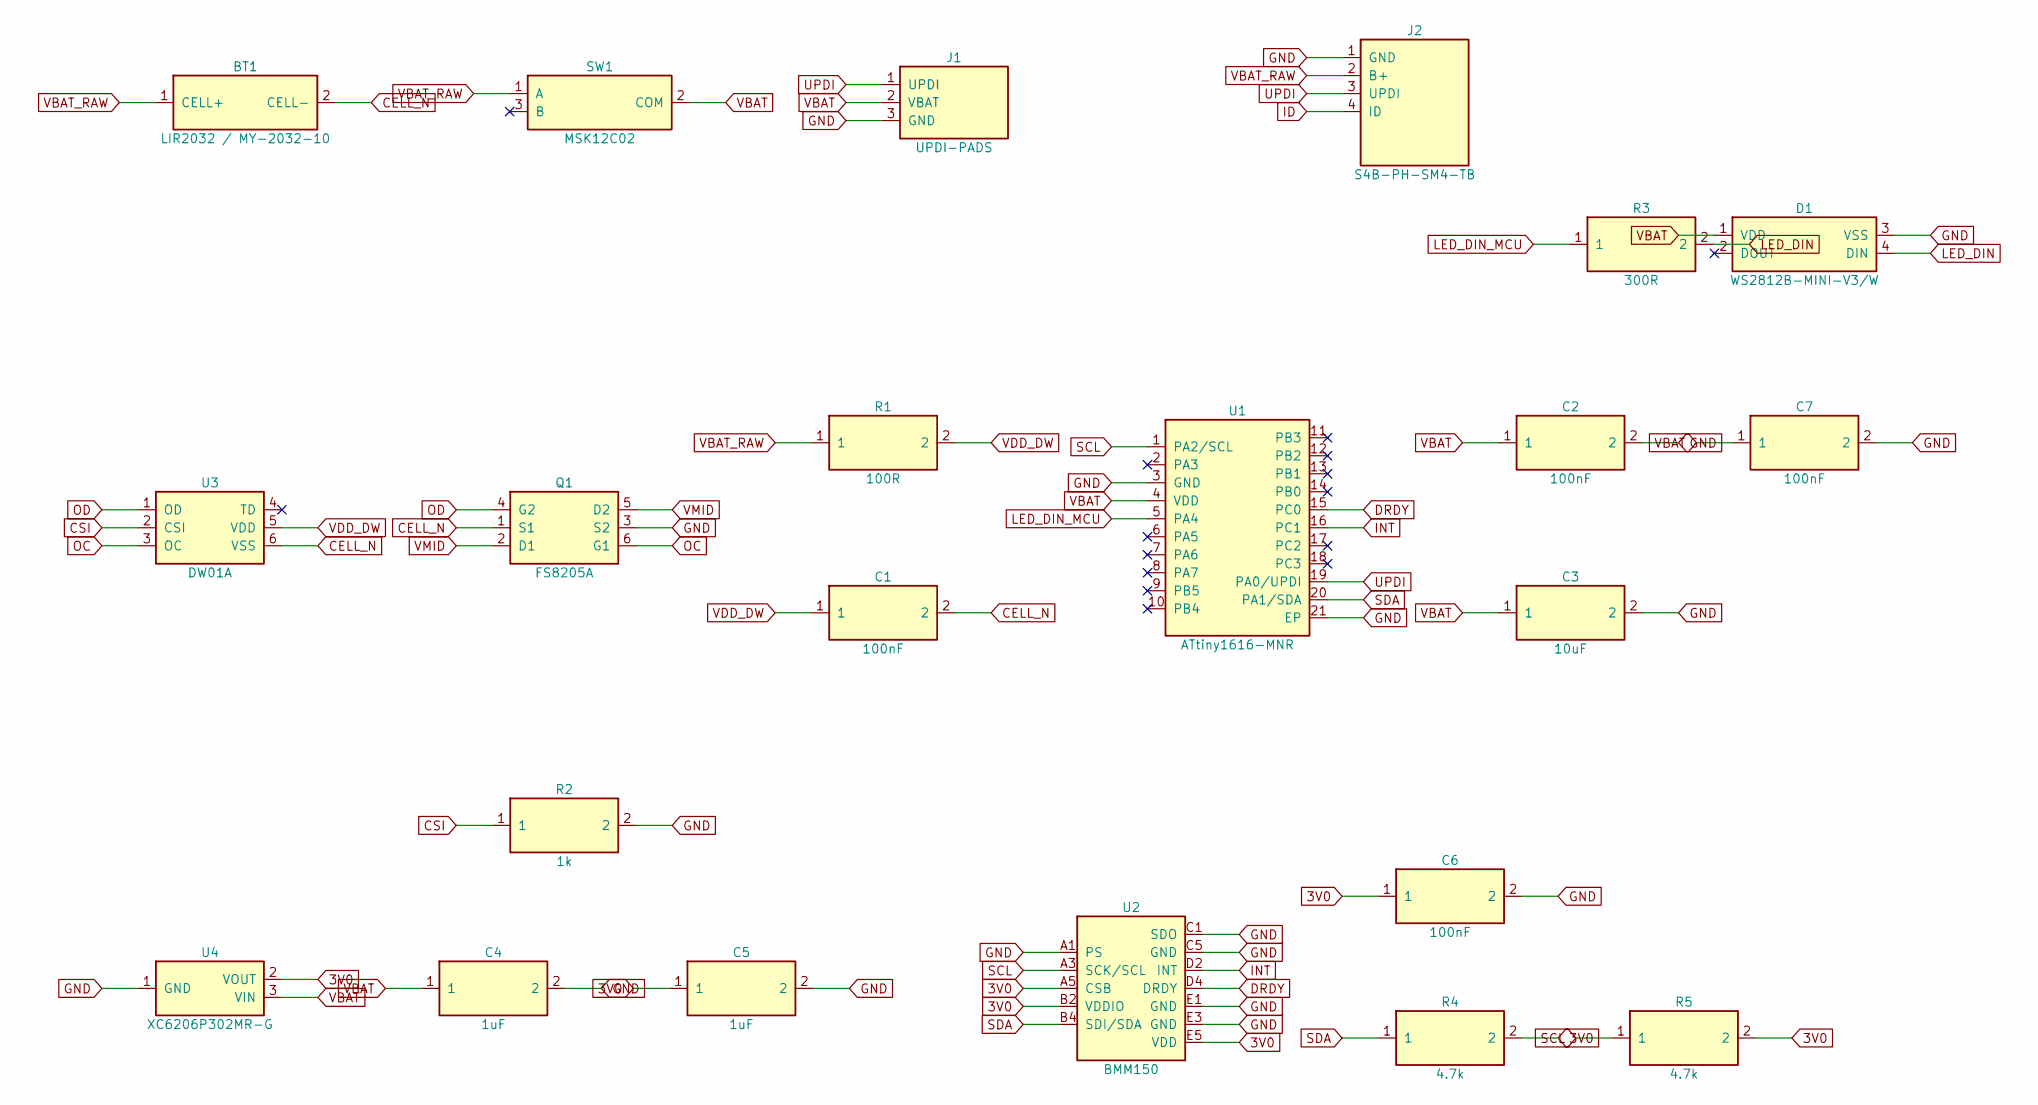
[picture p7: schematic magfield-node.kicad_sch, MAGFIELD NODE v1]

Parts:
BT1: LIR2032 / MY-2032-10; MY-2032-10; MPN MY-2032-10; LCSC C964827
C1, C2, C6, C7: 100nF; C_0603_1608Metric; MPN CL10B104KB8NNNC; LCSC C1591
C3: 10uF; C_0603_1608Metric; MPN CL10A106KP8NNNC; LCSC C19702
C4, C5: 1uF; C_0603_1608Metric; MPN CL10A105KB8NNNC; LCSC C15849
D1: WS2812B-MINI-V3/W; WS2812B-MINI; MPN WS2812B-MINI-V3/W; LCSC C527089
J1: UPDI-PADS; UPDI_PADS
J2: S4B-PH-SM4-TB; JST_PH_S4B-PH-SM4-TB_1x04-1MP_P2.00mm_Horizontal; MPN S4B-PH-SM4-TB(LF)(SN); LCSC C265102
Q1: FS8205A; SOT-23-6; MPN FS8205A; LCSC C2830320
R1: 100R; R_0603_1608Metric; MPN 0603WAF1000T5E; LCSC C22775
R2: 1k; R_0603_1608Metric; MPN 0603WAF1001T5E; LCSC C21190
R3: 300R; R_0603_1608Metric; MPN 0603WAF3000T5E; LCSC C23025
R4, R5: 4.7k; R_0603_1608Metric; MPN 0603WAF4701T5E; LCSC C23162
SW1: MSK12C02; SW_MSK12C02; MPN MSK12C02; LCSC C431540
U1: ATtiny1616-MNR; VQFN-20-1EP_3x3mm_P0.4mm_EP1.7x1.7mm; MPN ATTINY1616-MNR; LCSC C507118
U2: BMM150; BMM150_WLCSP12; MPN BMM150; LCSC C171681
U3: DW01A; SOT-23-6; MPN DW01A; LCSC C42459937
U4: XC6206P302MR-G; SOT-23; MPN XC6206P302MR-G; LCSC C9972

Connections:
3V0: C5.1, C6.1, R4.2, R5.2, U2.A5 (CSB), U2.B2 (VDDIO), U2.E5 (VDD), U4.2 (VOUT)
CELL_N: BT1.2 (CELL-), C1.2, Q1.1 (S1), U3.6 (VSS)
CSI: R2.1, U3.2 (CSI)
DRDY: U1.15 (PC0), U2.D4 (DRDY)
GND: C2.2, C3.2, C4.2, C5.2, C6.2, C7.2, D1.3 (VSS), J1.3 (GND), J2.1 (GND), J2.MP, Q1.3 (S2), R2.2, U1.3 (GND), U1.21 (EP), U2.A1 (PS), U2.C1 (SDO), U2.C5 (GND), U2.E1 (GND), U2.E3 (GND), U4.1 (GND)
ID: J2.4 (ID)
INT: U1.16 (PC1), U2.D2 (INT)
LED_DIN: D1.4 (DIN), R3.2
LED_DIN_MCU: R3.1, U1.5 (PA4)
OC: Q1.6 (G1), U3.3 (OC)
OD: Q1.4 (G2), U3.1 (OD)
SCL: R5.1, U1.1 (PA2/SCL), U2.A3 (SCK/SCL)
SDA: R4.1, U1.20 (PA1/SDA), U2.B4 (SDI/SDA)
UPDI: J1.1 (UPDI), J2.3 (UPDI), U1.19 (PA0/UPDI)
VBAT: C2.1, C3.1, C4.1, C7.1, D1.1 (VDD), J1.2 (VBAT), SW1.2 (COM), U1.4 (VDD), U4.3 (VIN)
VBAT_RAW: BT1.1 (CELL+), J2.2 (B+), R1.1, SW1.1 (A)
VDD_DW: C1.1, R1.2, U3.5 (VDD)
VMID: Q1.2 (D1), Q1.5 (D2)

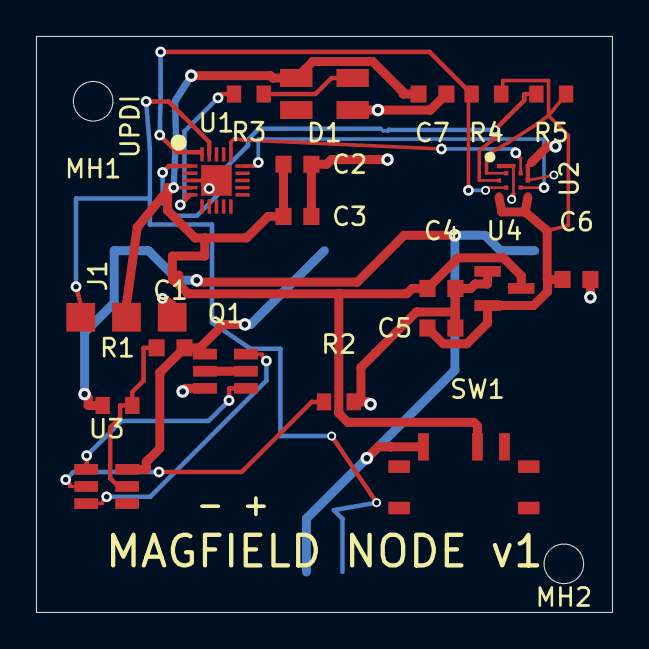
[picture p8: board magfield-node.kicad_pcb from above]

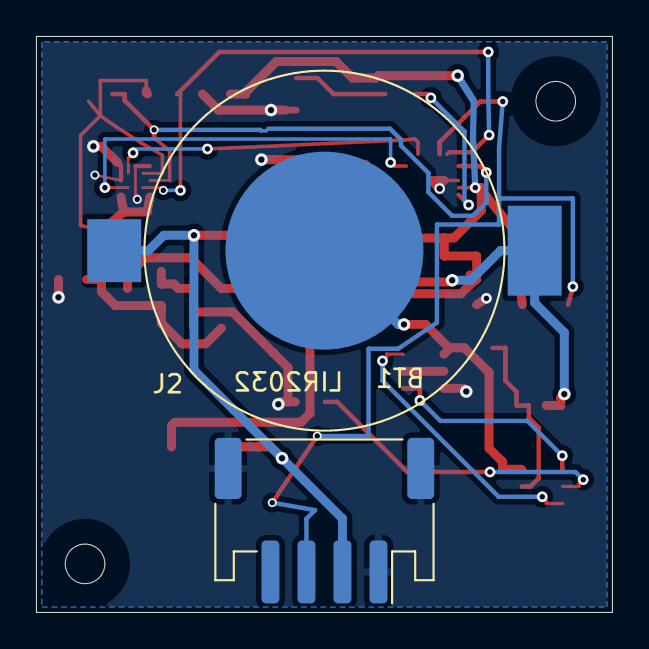
[picture p9: board magfield-node.kicad_pcb from below]

Board: 2 copper layers, 32.0 x 32.0 mm, 24 parts (2 on the bottom side), 17 nets.

Other parts of the board:
MH1, MH2: MountingHole_2.2mm_M2
