airpocket-soundman/magfield-nodes/charge-board/magfield-hub.kicad_pcb

## KiCad design charge-board/magfield-hub.kicad_pcb (2026-10-30)

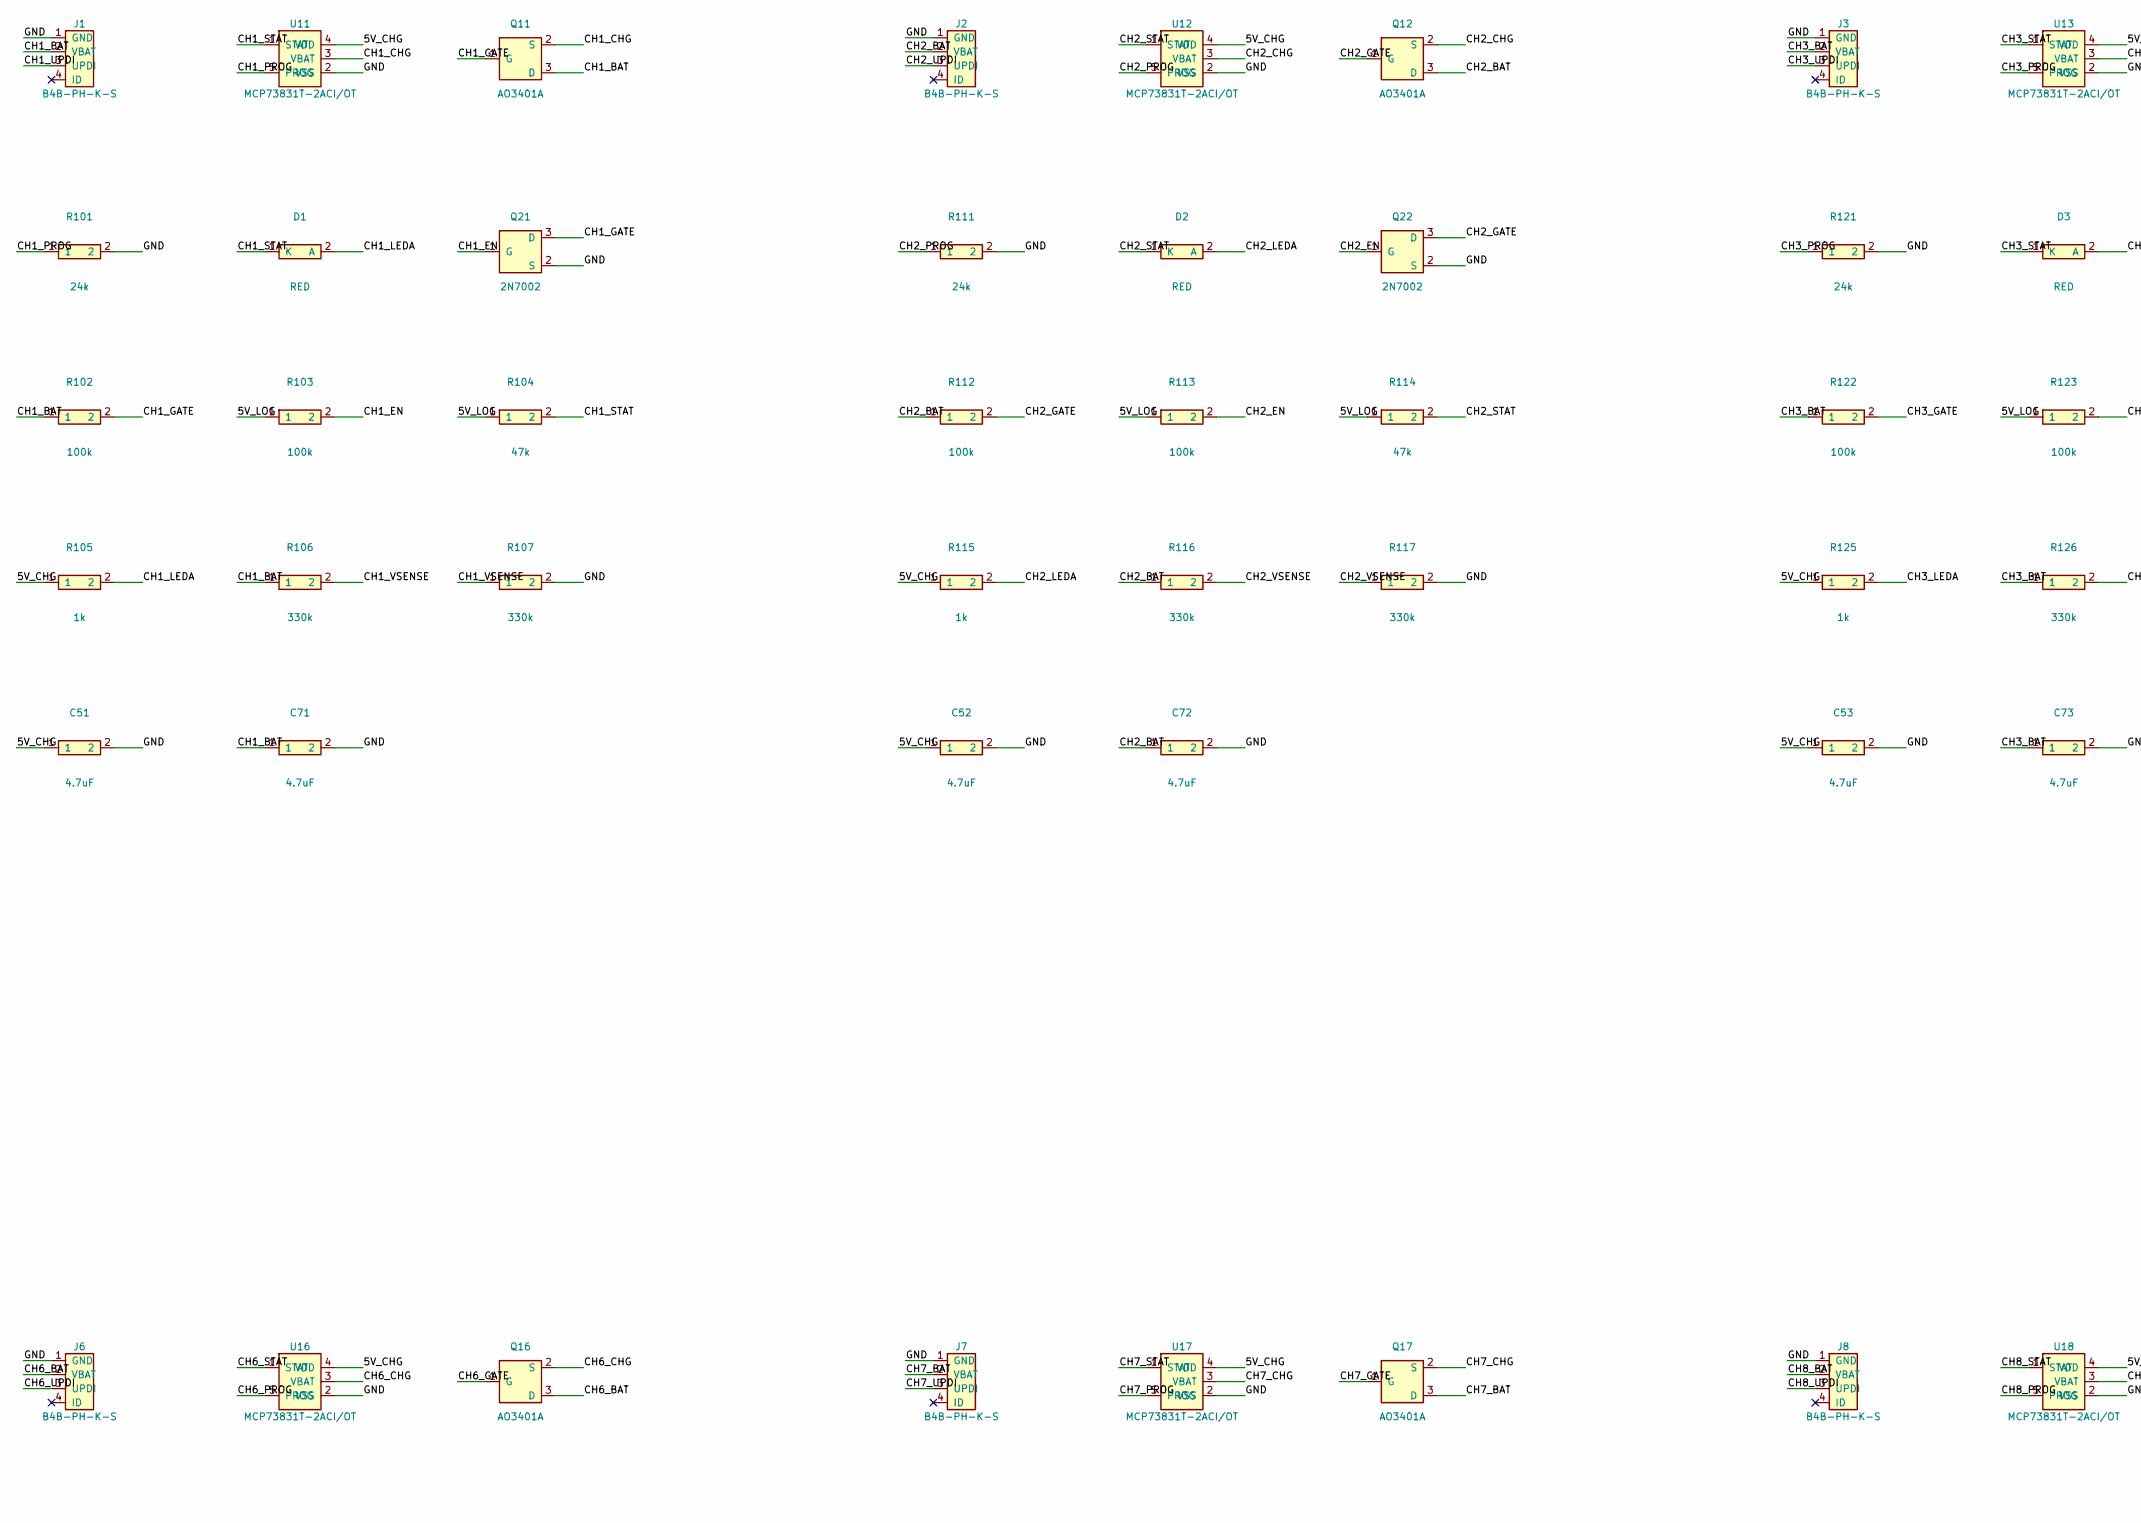
[picture p10: schematic magfield-hub.kicad_sch, MAGFIELD DOCK v1, part in row 1, column 1]

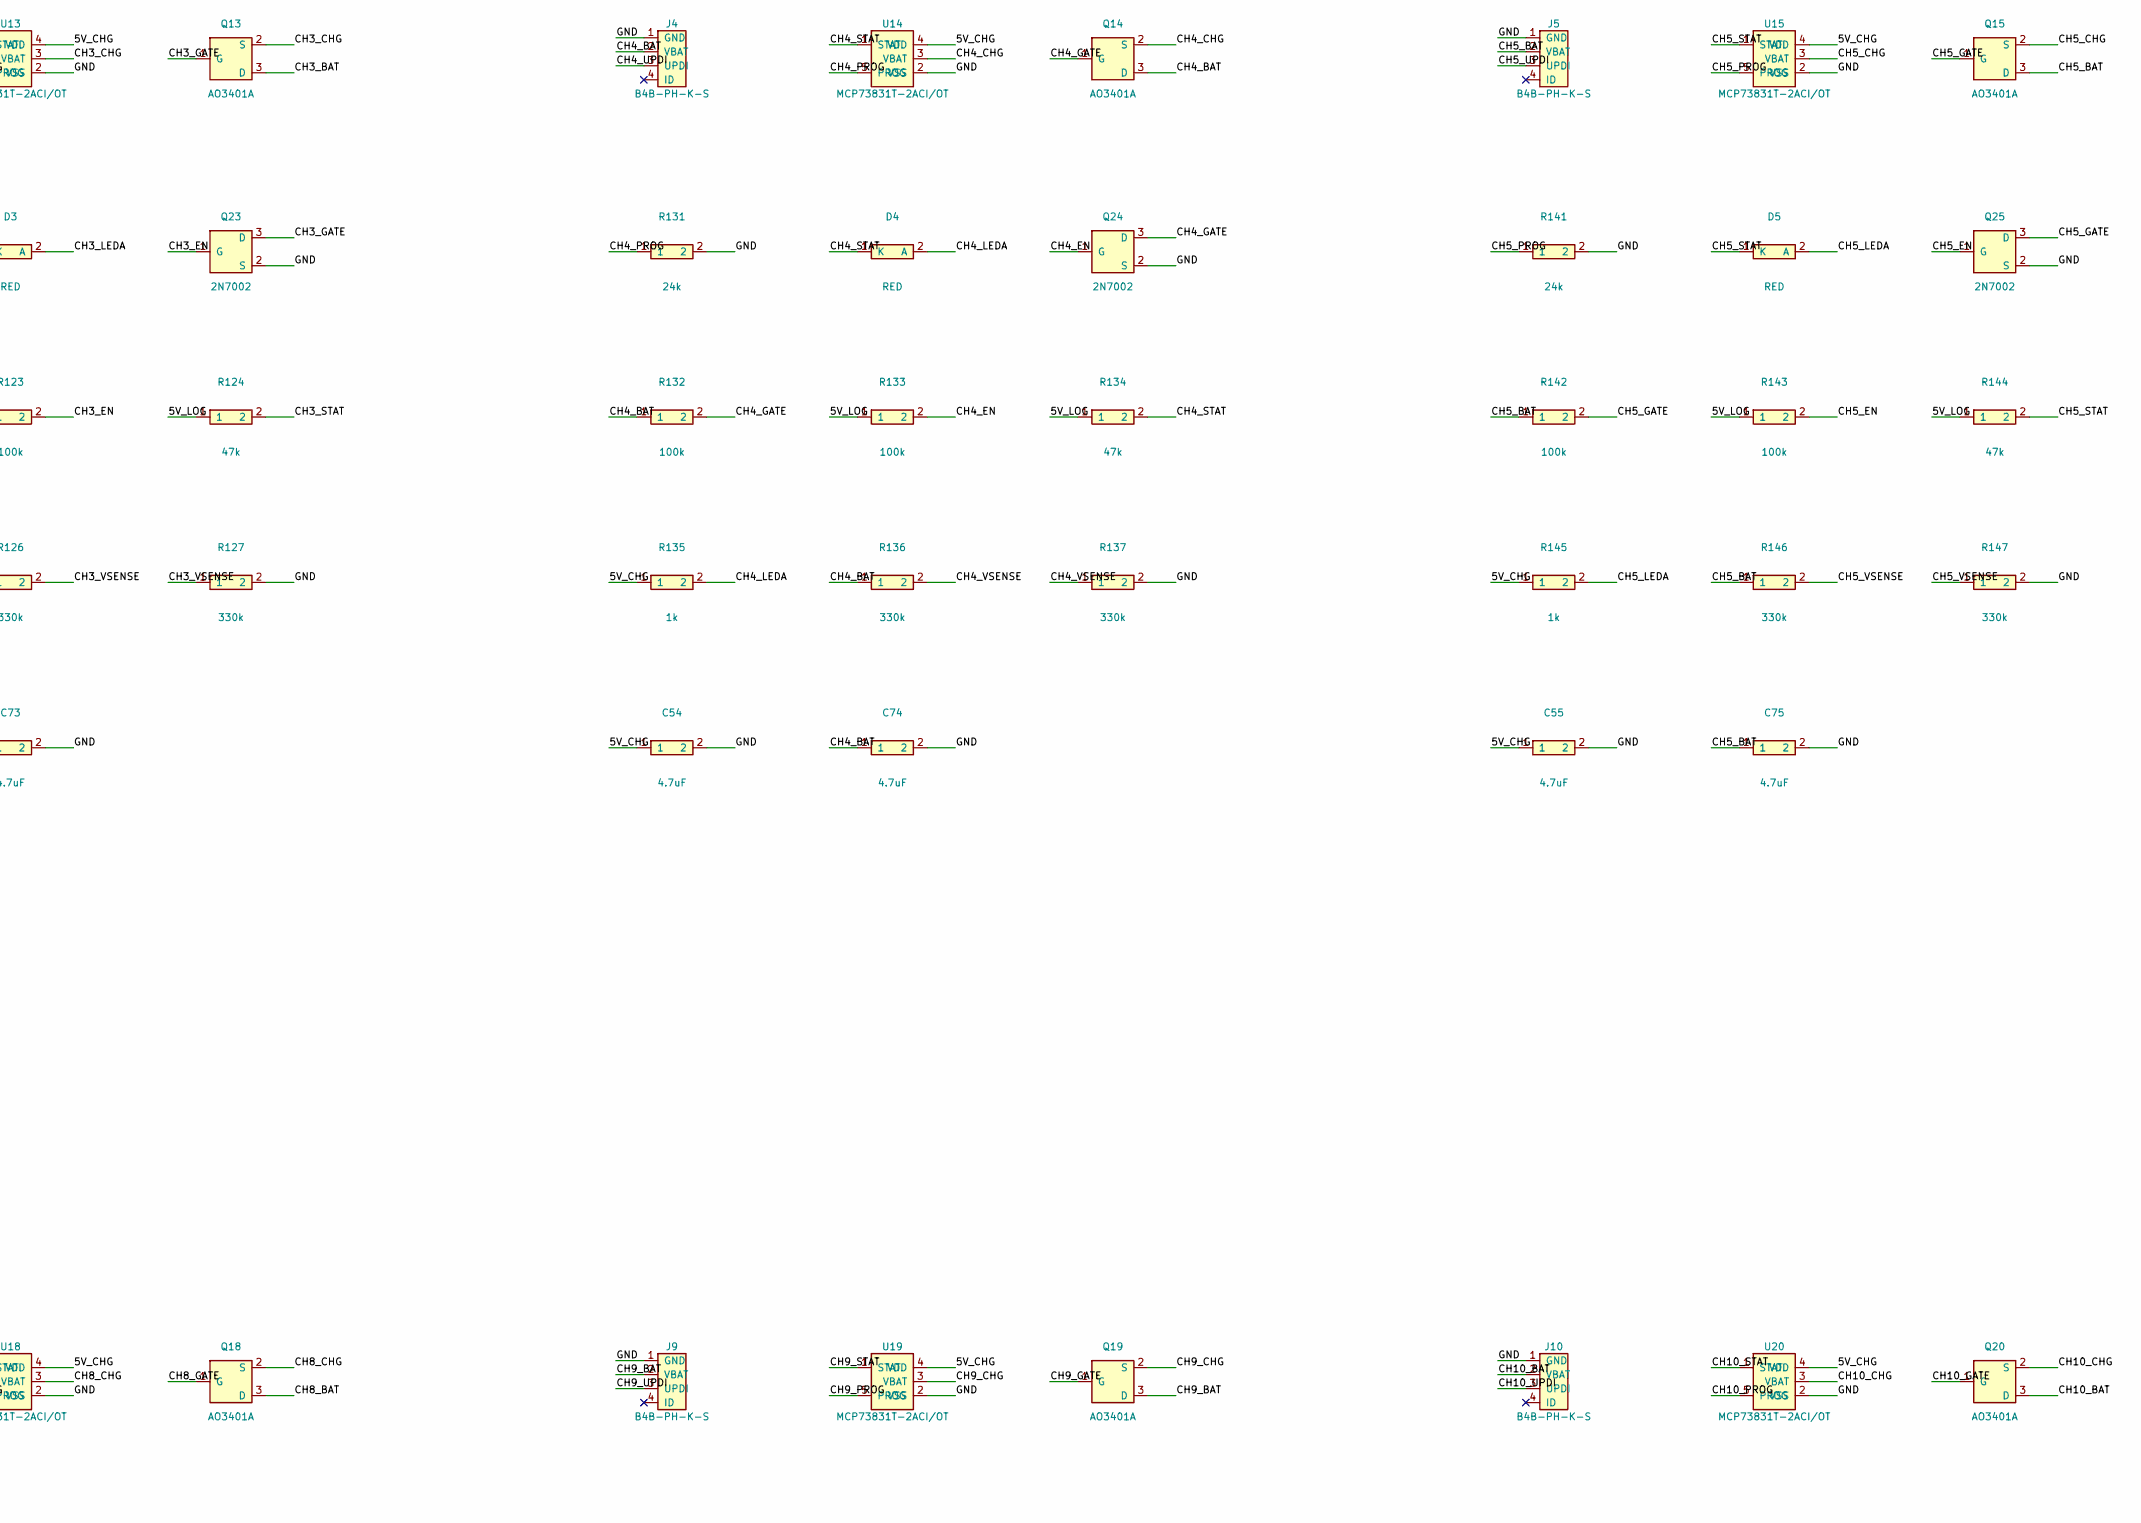
[picture p11: schematic magfield-hub.kicad_sch, MAGFIELD DOCK v1, part in row 1, column 2]

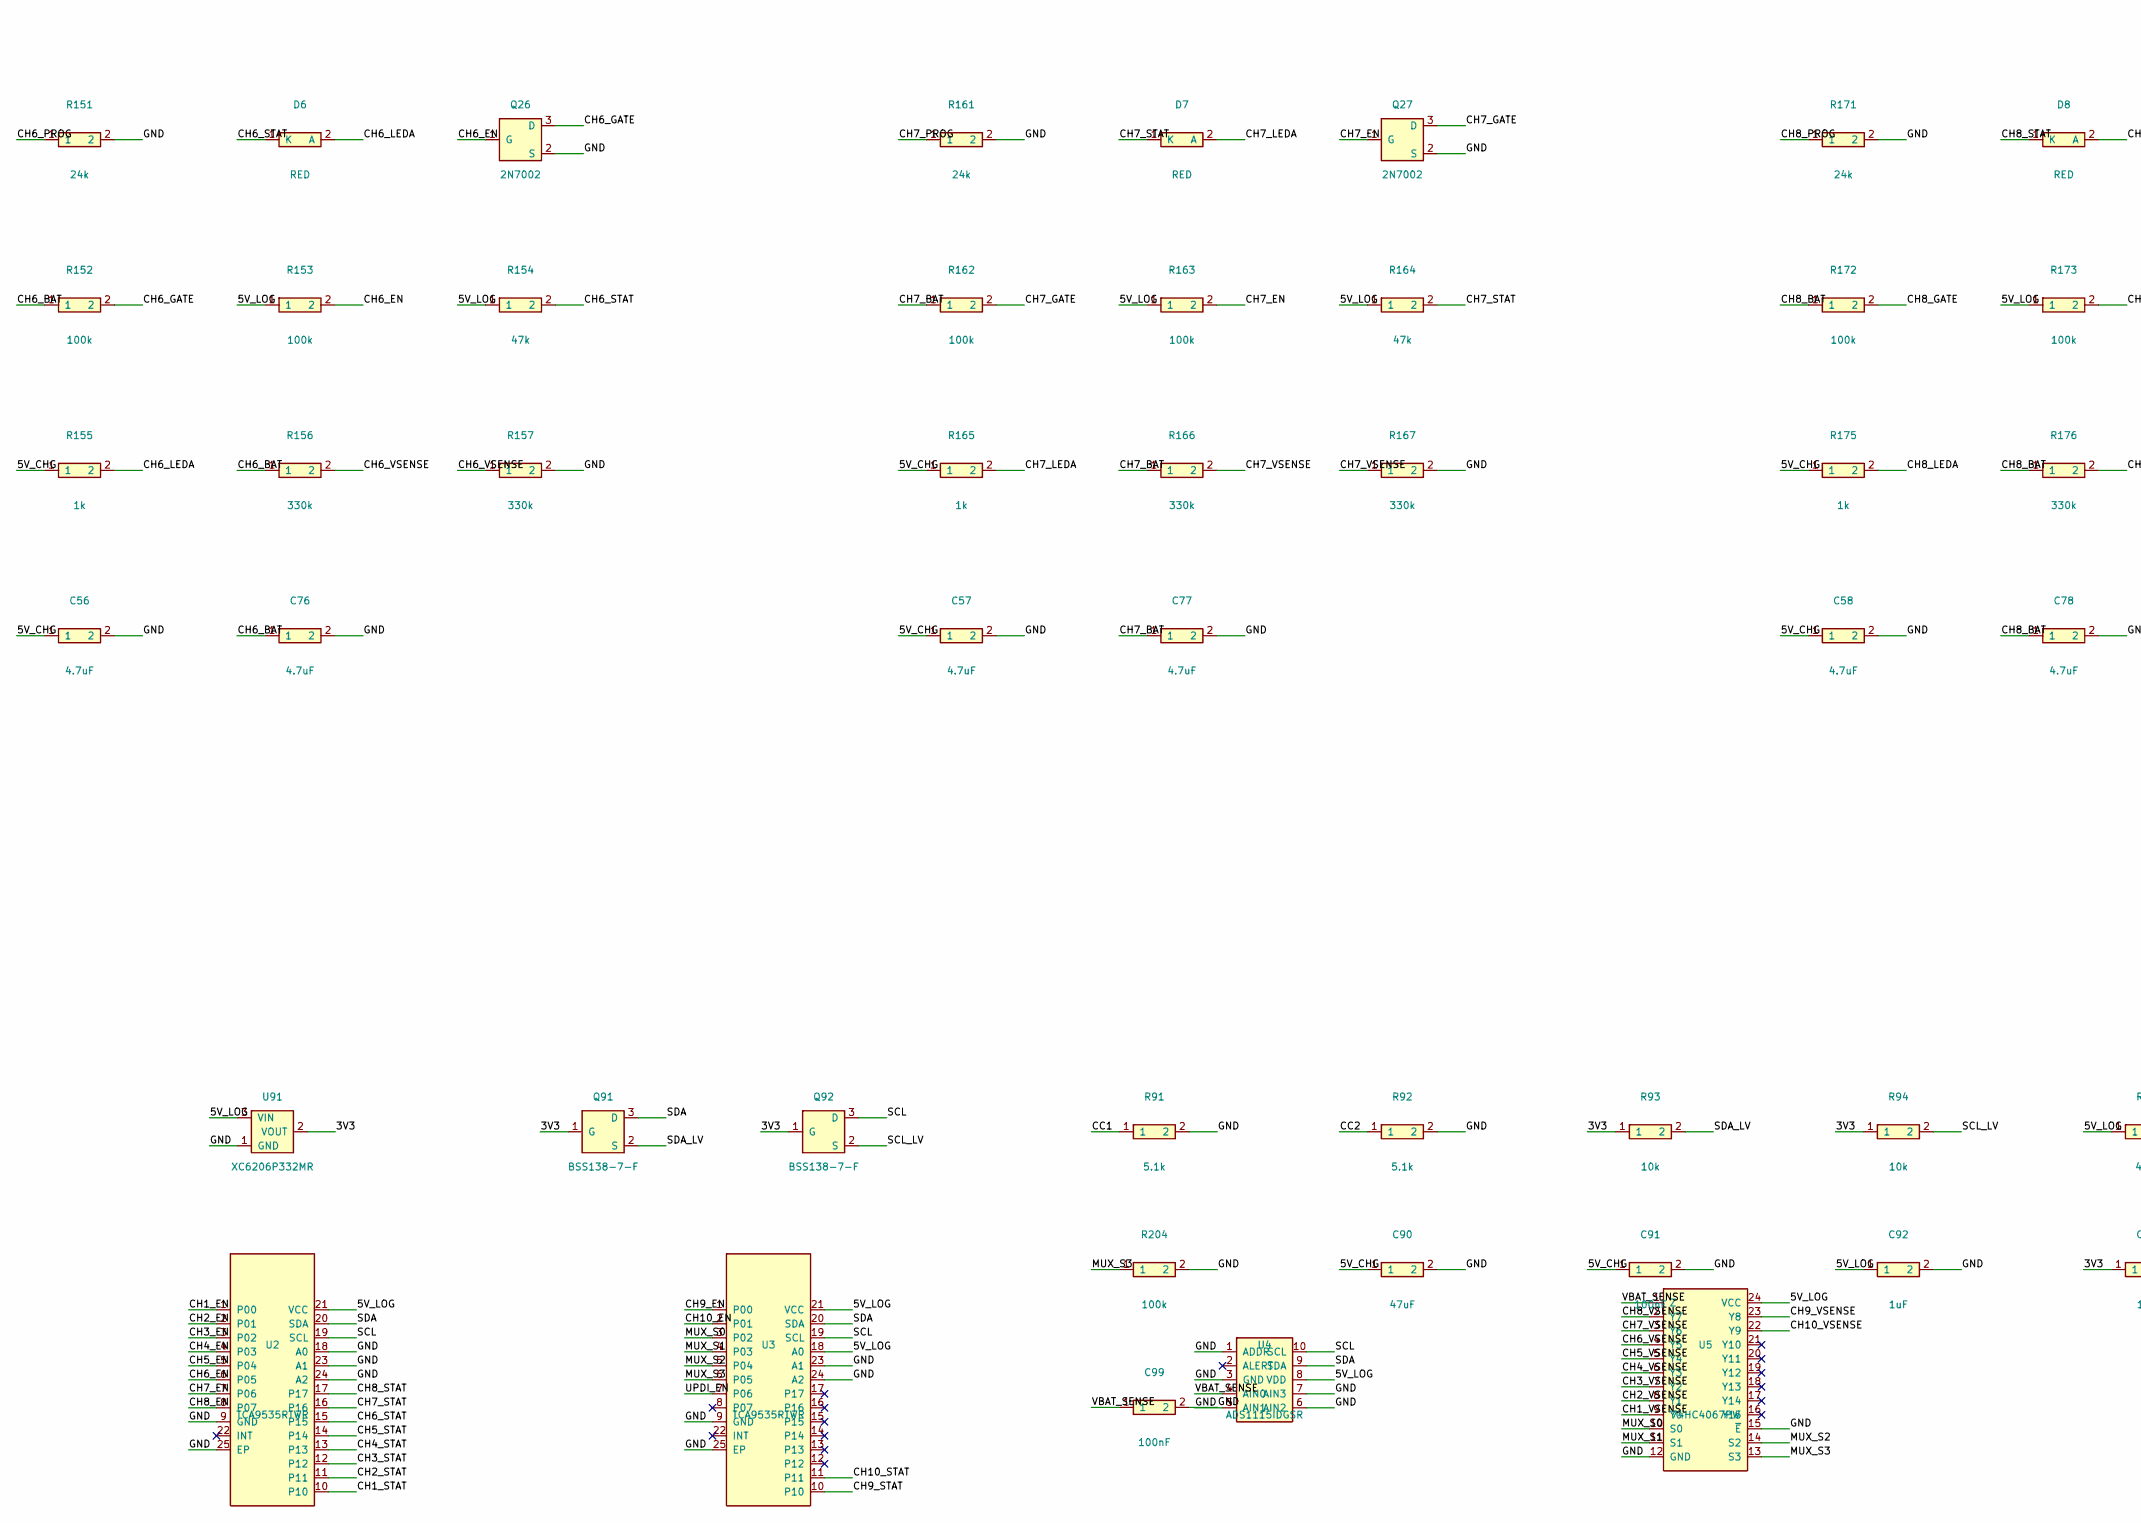
[picture p12: schematic magfield-hub.kicad_sch, MAGFIELD DOCK v1, part in row 2, column 1]

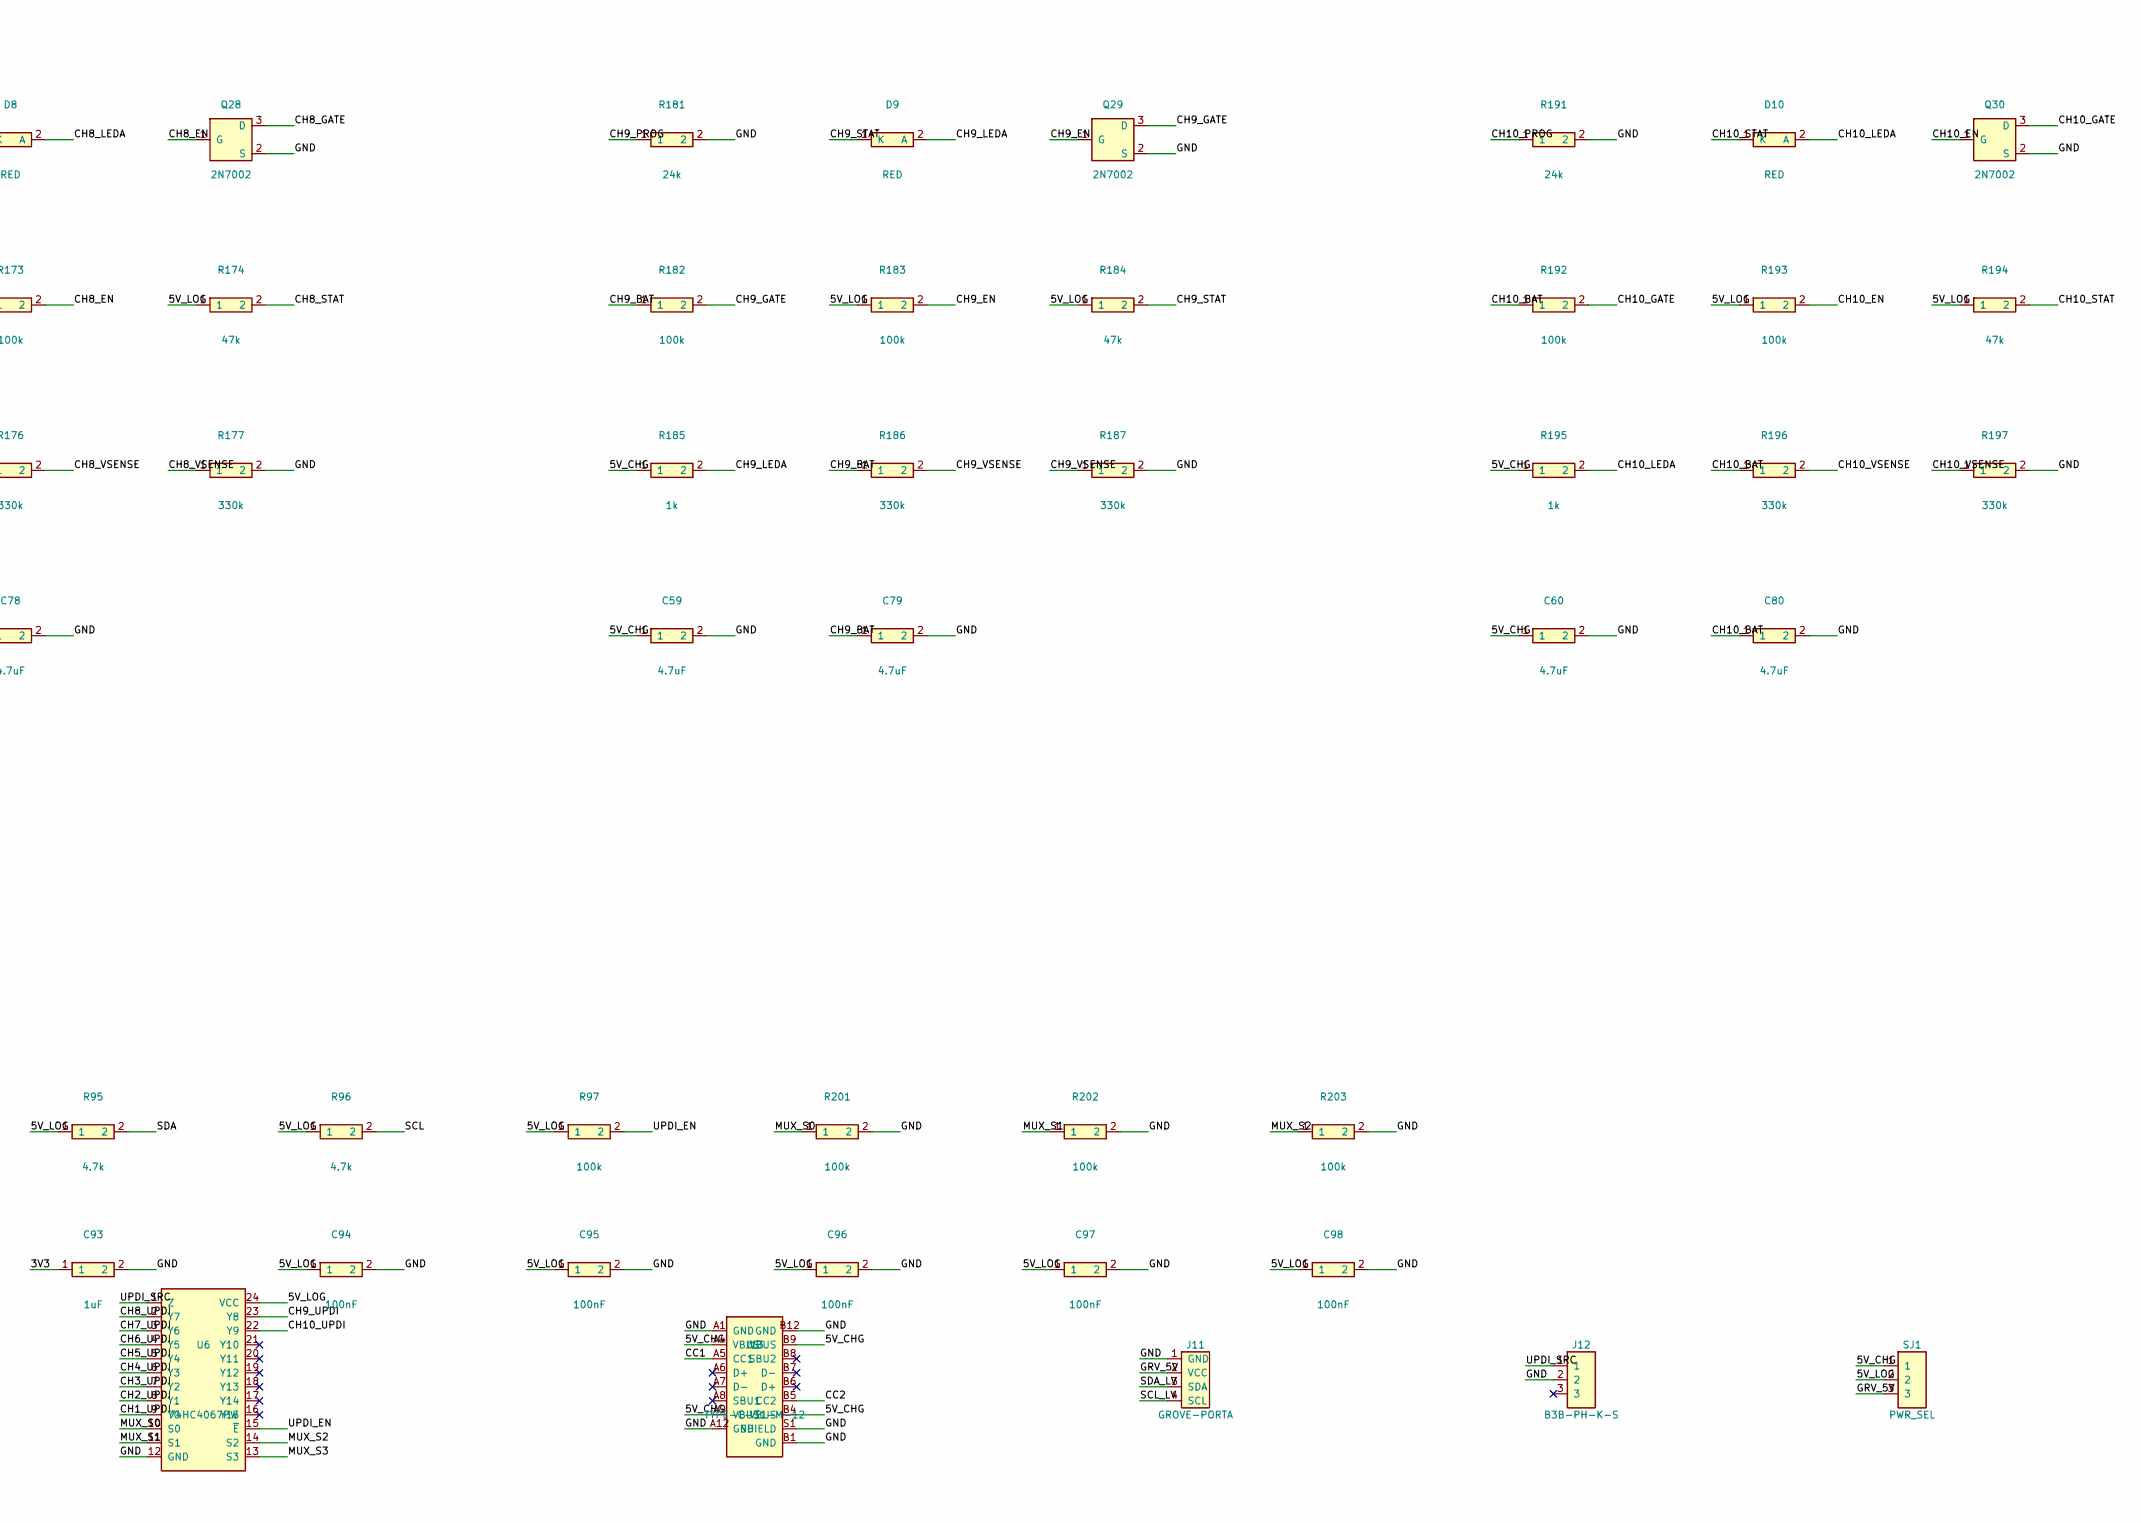
[picture p13: schematic magfield-hub.kicad_sch, MAGFIELD DOCK v1, part in row 2, column 2]

Parts:
C51, C52, C53, C54, C55, C56, C57, C58, C59, C60, C71, C72, C73, C74, C75, C76, C77, C78, C79, C80: 4.7uF; C_0603_1608Metric; LCSC C19666
C90: 47uF; C_0805_2012Metric; LCSC C16780
C91, C94, C95, C96, C97, C98, C99: 100nF; C_0603_1608Metric; LCSC C14663
C92, C93: 1uF; C_0603_1608Metric; LCSC C15849
D1, D2, D3, D4, D5, D6, D7, D8, D9, D10: RED; LED_0603_1608Metric; LCSC C2286
J1, J2, J3, J4, J5, J6, J7, J8, J9, J10: B4B-PH-K-S; JST_PH_B4B-PH-K_1x04_P2.00mm_Vertical; LCSC C131334
J11: GROVE-PORTA; JST_PH_B4B-PH-K_1x04_P2.00mm_Vertical; LCSC C131334
J12: B3B-PH-K-S; JST_PH_B3B-PH-K_1x03_P2.00mm_Vertical; LCSC C131339
J13: TYPE-C-31-M-12; USB_C_Receptacle_HRO_TYPE-C-31-M-12; LCSC C165948
Q11, Q12, Q13, Q14, Q15, Q16, Q17, Q18, Q19, Q20: AO3401A; SOT-23; LCSC C15127
Q21, Q22, Q23, Q24, Q25, Q26, Q27, Q28, Q29, Q30: 2N7002; SOT-23; LCSC C8545
Q91, Q92: BSS138-7-F; SOT-23; LCSC C40912
R91, R92: 5.1k; R_0603_1608Metric; LCSC C23186
R93, R94: 10k; R_0603_1608Metric; LCSC C25804
R95, R96: 4.7k; R_0603_1608Metric; LCSC C23162
R97, R102, R103, R112, R113, R122, R123, R132, R133, R142, R143, R152, R153, R162, R163, R172, R173, R182, R183, R192, R193, R201, R202, R203, R204: 100k; R_0603_1608Metric; LCSC C25803
R101, R111, R121, R131, R141, R151, R161, R171, R181, R191: 24k; R_0603_1608Metric; LCSC C23352
R104, R114, R124, R134, R144, R154, R164, R174, R184, R194: 47k; R_0603_1608Metric; LCSC C25819
R105, R115, R125, R135, R145, R155, R165, R175, R185, R195: 1k; R_0603_1608Metric; LCSC C21190
R106, R107, R116, R117, R126, R127, R136, R137, R146, R147, R156, R157, R166, R167, R176, R177, R186, R187, R196, R197: 330k; R_0603_1608Metric; LCSC C23137
SJ1: PWR_SEL; SJ3
U2, U3: TCA9535RTWR; WQFN-24-1EP_4x4mm_P0.5mm_EP2.45x2.45mm; LCSC C129354
U4: ADS1115IDGSR; VSSOP-10_3x3mm_P0.5mm; LCSC C37593
U5, U6: 74HC4067PW; TSSOP-24_4.4x7.8mm_P0.65mm; LCSC C179326
U11, U12, U13, U14, U15, U16, U17, U18, U19, U20: MCP73831T-2ACI/OT; SOT-23-5; LCSC C424093
U91: XC6206P332MR; SOT-23; LCSC C5446

Connections:
3V3: C93.1, Q91.1 (G), Q92.1 (G), R93.1, R94.1, U91.2 (VOUT)
5V_CHG: C51.1, C52.1, C53.1, C54.1, C55.1, C56.1, C57.1, C58.1, C59.1, C60.1, C90.1, C91.1, J13.A4 (VBUS), J13.A9 (VBUS), J13.B4 (VBUS), J13.B9 (VBUS), R105.1, R115.1, R125.1, R135.1, R145.1, R155.1, R165.1, R175.1, R185.1, R195.1, SJ1.1, U11.4 (VDD), U12.4 (VDD), U13.4 (VDD), U14.4 (VDD), U15.4 (VDD), U16.4 (VDD), U17.4 (VDD), U18.4 (VDD), U19.4 (VDD), U20.4 (VDD)
5V_LOG: C92.1, C94.1, C95.1, C96.1, C97.1, C98.1, R95.1, R96.1, R97.1, R103.1, R104.1, R113.1, R114.1, R123.1, R124.1, R133.1, R134.1, R143.1, R144.1, R153.1, R154.1, R163.1, R164.1, R173.1, R174.1, R183.1, R184.1, R193.1, R194.1, SJ1.2, U2.21 (VCC), U3.18 (A0), U3.21 (VCC), U4.8 (VDD), U5.24 (VCC), U6.24 (VCC), U91.3 (VIN)
CC1: J13.A5 (CC1), R91.1
CC2: J13.B5 (CC2), R92.1
CH1_BAT: C71.1, J1.2 (VBAT), Q11.3 (D), R102.1, R106.1
CH1_CHG: Q11.2 (S), U11.3 (VBAT)
CH1_EN: Q21.1 (G), R103.2, U2.1 (P00)
CH1_GATE: Q11.1 (G), Q21.3 (D), R102.2
CH1_LEDA: D1.2 (A), R105.2
CH1_PROG: R101.1, U11.5 (PROG)
CH1_STAT: D1.1 (K), R104.2, U2.10, U11.1 (STAT)
CH1_UPDI: J1.3 (UPDI), U6.9 (Y0)
CH1_VSENSE: R106.2, R107.1, U5.9 (Y0)
CH2_BAT: C72.1, J2.2 (VBAT), Q12.3 (D), R112.1, R116.1
CH2_CHG: Q12.2 (S), U12.3 (VBAT)
CH2_EN: Q22.1 (G), R113.2, U2.2 (P01)
CH2_GATE: Q12.1 (G), Q22.3 (D), R112.2
CH2_LEDA: D2.2 (A), R115.2
CH2_PROG: R111.1, U12.5 (PROG)
CH2_STAT: D2.1 (K), R114.2, U2.11, U12.1 (STAT)
CH2_UPDI: J2.3 (UPDI), U6.8 (Y1)
CH2_VSENSE: R116.2, R117.1, U5.8 (Y1)
CH3_BAT: C73.1, J3.2 (VBAT), Q13.3 (D), R122.1, R126.1
CH3_CHG: Q13.2 (S), U13.3 (VBAT)
CH3_EN: Q23.1 (G), R123.2, U2.3 (P02)
CH3_GATE: Q13.1 (G), Q23.3 (D), R122.2
CH3_LEDA: D3.2 (A), R125.2
CH3_PROG: R121.1, U13.5 (PROG)
CH3_STAT: D3.1 (K), R124.2, U2.12, U13.1 (STAT)
CH3_UPDI: J3.3 (UPDI), U6.7 (Y2)
CH3_VSENSE: R126.2, R127.1, U5.7 (Y2)
CH4_BAT: C74.1, J4.2 (VBAT), Q14.3 (D), R132.1, R136.1
CH4_CHG: Q14.2 (S), U14.3 (VBAT)
CH4_EN: Q24.1 (G), R133.2, U2.4 (P03)
CH4_GATE: Q14.1 (G), Q24.3 (D), R132.2
CH4_LEDA: D4.2 (A), R135.2
CH4_PROG: R131.1, U14.5 (PROG)
CH4_STAT: D4.1 (K), R134.2, U2.13, U14.1 (STAT)
CH4_UPDI: J4.3 (UPDI), U6.6 (Y3)
CH4_VSENSE: R136.2, R137.1, U5.6 (Y3)
CH5_BAT: C75.1, J5.2 (VBAT), Q15.3 (D), R142.1, R146.1
CH5_CHG: Q15.2 (S), U15.3 (VBAT)
CH5_EN: Q25.1 (G), R143.2, U2.5 (P04)
CH5_GATE: Q15.1 (G), Q25.3 (D), R142.2
CH5_LEDA: D5.2 (A), R145.2
CH5_PROG: R141.1, U15.5 (PROG)
CH5_STAT: D5.1 (K), R144.2, U2.14, U15.1 (STAT)
CH5_UPDI: J5.3 (UPDI), U6.5 (Y4)
CH5_VSENSE: R146.2, R147.1, U5.5 (Y4)
CH6_BAT: C76.1, J6.2 (VBAT), Q16.3 (D), R152.1, R156.1
CH6_CHG: Q16.2 (S), U16.3 (VBAT)
CH6_EN: Q26.1 (G), R153.2, U2.6 (P05)
CH6_GATE: Q16.1 (G), Q26.3 (D), R152.2
CH6_LEDA: D6.2 (A), R155.2
CH6_PROG: R151.1, U16.5 (PROG)
CH6_STAT: D6.1 (K), R154.2, U2.15, U16.1 (STAT)
CH6_UPDI: J6.3 (UPDI), U6.4 (Y5)
CH6_VSENSE: R156.2, R157.1, U5.4 (Y5)
CH7_BAT: C77.1, J7.2 (VBAT), Q17.3 (D), R162.1, R166.1
CH7_CHG: Q17.2 (S), U17.3 (VBAT)
CH7_EN: Q27.1 (G), R163.2, U2.7 (P06)
CH7_GATE: Q17.1 (G), Q27.3 (D), R162.2
CH7_LEDA: D7.2 (A), R165.2
CH7_PROG: R161.1, U17.5 (PROG)
CH7_STAT: D7.1 (K), R164.2, U2.16, U17.1 (STAT)
CH7_UPDI: J7.3 (UPDI), U6.3 (Y6)
CH7_VSENSE: R166.2, R167.1, U5.3 (Y6)
CH8_BAT: C78.1, J8.2 (VBAT), Q18.3 (D), R172.1, R176.1
CH8_CHG: Q18.2 (S), U18.3 (VBAT)
CH8_EN: Q28.1 (G), R173.2, U2.8 (P07)
CH8_GATE: Q18.1 (G), Q28.3 (D), R172.2
CH8_LEDA: D8.2 (A), R175.2
CH8_PROG: R171.1, U18.5 (PROG)
CH8_STAT: D8.1 (K), R174.2, U2.17, U18.1 (STAT)
CH8_UPDI: J8.3 (UPDI), U6.2 (Y7)
CH8_VSENSE: R176.2, R177.1, U5.2 (Y7)
CH9_BAT: C79.1, J9.2 (VBAT), Q19.3 (D), R182.1, R186.1
CH9_CHG: Q19.2 (S), U19.3 (VBAT)
CH9_EN: Q29.1 (G), R183.2, U3.1 (P00)
CH9_GATE: Q19.1 (G), Q29.3 (D), R182.2
CH9_LEDA: D9.2 (A), R185.2
CH9_PROG: R181.1, U19.5 (PROG)
CH9_STAT: D9.1 (K), R184.2, U3.10, U19.1 (STAT)
CH9_UPDI: J9.3 (UPDI), U6.23 (Y8)
CH9_VSENSE: R186.2, R187.1, U5.23 (Y8)
CH10_BAT: C80.1, J10.2 (VBAT), Q20.3 (D), R192.1, R196.1
CH10_CHG: Q20.2 (S), U20.3 (VBAT)
CH10_EN: Q30.1 (G), R193.2, U3.2 (P01)
CH10_GATE: Q20.1 (G), Q30.3 (D), R192.2
CH10_LEDA: D10.2 (A), R195.2
CH10_PROG: R191.1, U20.5 (PROG)
CH10_STAT: D10.1 (K), R194.2, U3.11, U20.1 (STAT)
CH10_UPDI: J10.3 (UPDI), U6.22 (Y9)
CH10_VSENSE: R196.2, R197.1, U5.22 (Y9)
GND: C51.2, C52.2, C53.2, C54.2, C55.2, C56.2, C57.2, C58.2, C59.2, C60.2, C71.2, C72.2, C73.2, C74.2, C75.2, C76.2, C77.2, C78.2, C79.2, C80.2, C90.2, C91.2, C92.2, C93.2, C94.2, C95.2, C96.2, C97.2, C98.2, C99.2, J1.1 (GND), J2.1 (GND), J3.1 (GND), J4.1 (GND), J5.1 (GND), J6.1 (GND), J7.1 (GND), J8.1 (GND), J9.1 (GND), J10.1 (GND), J11.1 (GND), J12.2, J13.A1 (GND), J13.A12 (GND), J13.B1 (GND), J13.B12 (GND), J13.S1 (SHIELD), Q21.2 (S), Q22.2 (S), Q23.2 (S), Q24.2 (S), Q25.2 (S), Q26.2 (S), Q27.2 (S), Q28.2 (S), Q29.2 (S), Q30.2 (S), R91.2, R92.2, R101.2, R107.2, R111.2, R117.2, R121.2, R127.2, R131.2, R137.2, R141.2, R147.2, R151.2, R157.2, R161.2, R167.2, R171.2, R177.2, R181.2, R187.2, R191.2, R197.2, R201.2, R202.2, R203.2, R204.2, U2.9 (GND), U2.18 (A0), U2.23 (A1), U2.24 (A2), U2.25 (EP), U3.9 (GND), U3.23 (A1), U3.24 (A2), U3.25 (EP), U4.1 (ADDR), U4.3 (GND), U4.5 (AIN1), U4.6 (AIN2), U4.7 (AIN3), U5.12 (GND), U5.15 (~E), U6.12 (GND), U11.2 (VSS), U12.2 (VSS), U13.2 (VSS), U14.2 (VSS), U15.2 (VSS), U16.2 (VSS), U17.2 (VSS), U18.2 (VSS), U19.2 (VSS), U20.2 (VSS), U91.1 (GND)
GRV_5V: J11.2 (VCC), SJ1.3
MUX_S0: R201.1, U3.3 (P02), U5.10 (S0), U6.10 (S0)
MUX_S1: R202.1, U3.4 (P03), U5.11 (S1), U6.11 (S1)
MUX_S2: R203.1, U3.5 (P04), U5.14 (S2), U6.14 (S2)
MUX_S3: R204.1, U3.6 (P05), U5.13 (S3), U6.13 (S3)
SCL: Q92.3 (D), R96.2, U2.19 (SCL), U3.19 (SCL), U4.10 (SCL)
SCL_LV: J11.4 (SCL), Q92.2 (S), R94.2
SDA: Q91.3 (D), R95.2, U2.20 (SDA), U3.20 (SDA), U4.9 (SDA)
SDA_LV: J11.3 (SDA), Q91.2 (S), R93.2
UPDI_EN: R97.2, U3.7 (P06), U6.15 (~E)
UPDI_SRC: J12.1, U6.1 (Z)
VBAT_SENSE: C99.1, U4.4 (AIN0), U5.1 (Z)
