airpocket-soundman/magfield-nodes/charge-board/magfield-hub.kicad_pcb

## KiCad design charge-board/magfield-hub.kicad_pcb (continued)

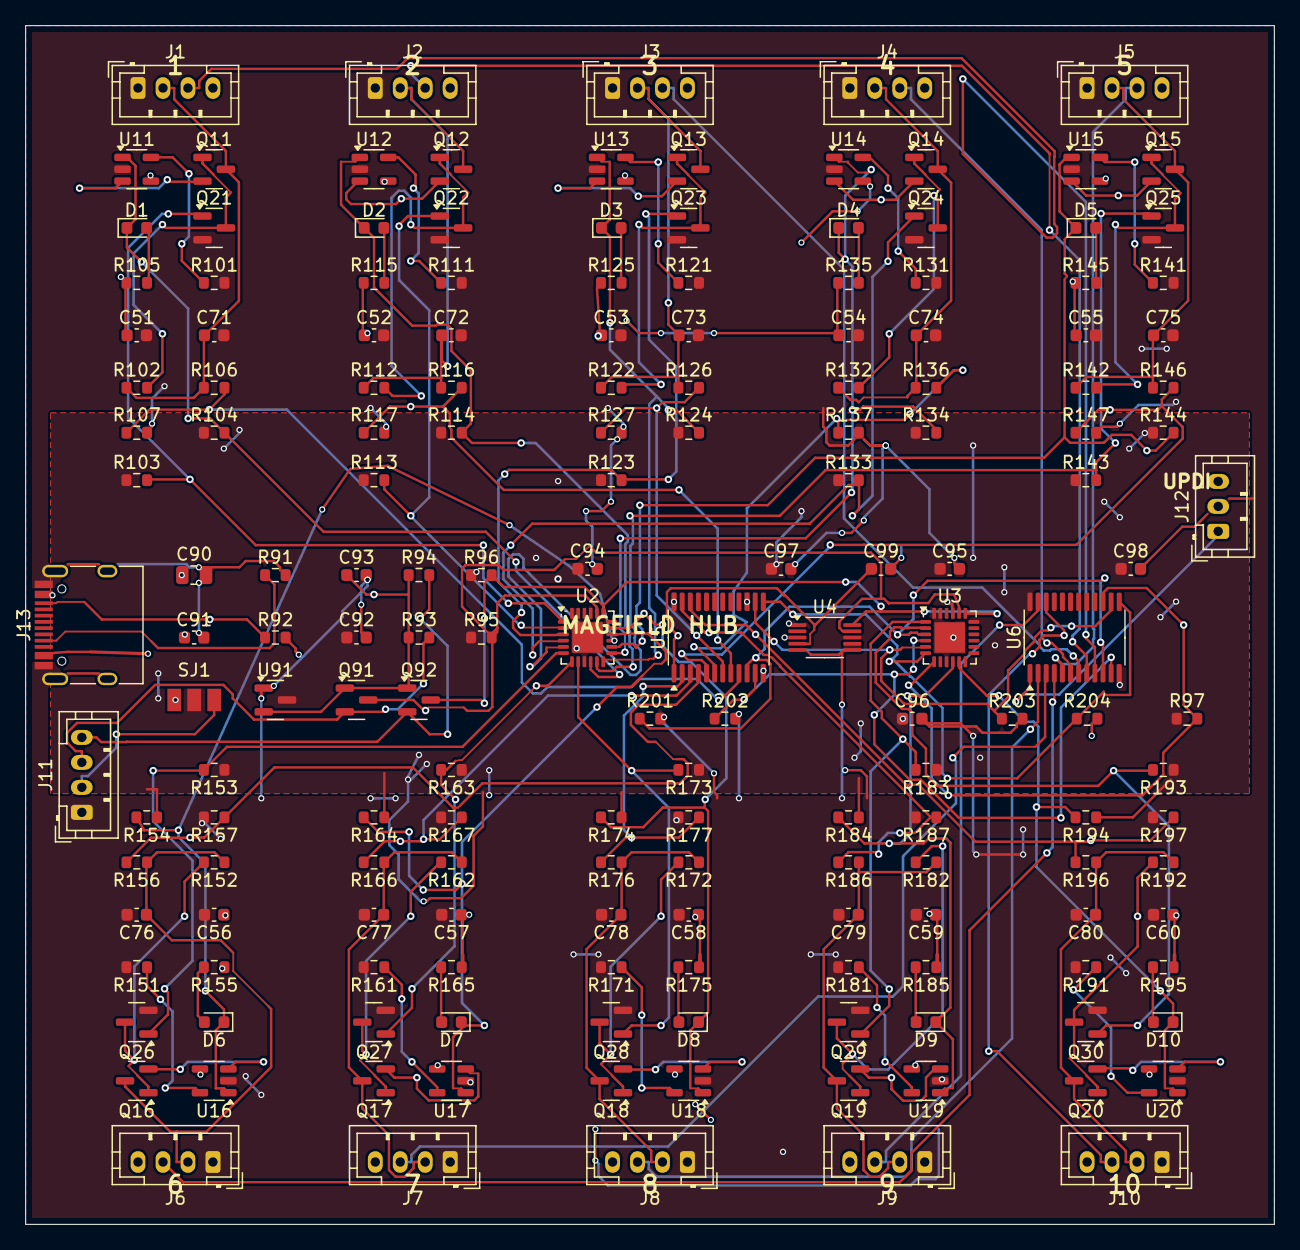
[picture p14: board magfield-hub.kicad_pcb from above]

Board: 4 copper layers, 100.0 x 96.0 mm, 173 parts (0 on the bottom side), 108 nets.
