airpocket-soundman/magfield-nodes/(commit log)

2026-10-29 Initial commit: magfield node board v3 design, BOM estimate, charge board plan
    [magfield-node-B_Courtyard.gbr, magfield-node-B_Cu.gbl, magfield-node-B_Fab.gbr, magfield-node-B_Mask.gbs, magfield-node-B_Paste.gbp, magfield-node-B_Silkscreen.gbo, magfield-node-Edge_Cuts.gm1, magfield-node-F_Courtyard.gbr]
2026-10-29 Add board images
2026-10-30 Standardize node parts to LCSC/JLCPCB-PCBA verified BOM; fix CPL coordinates
    [magfield-node-B_Courtyard.gbr, magfield-node-B_Cu.gbl, magfield-node-B_Fab.gbr, magfield-node-B_Mask.gbs, magfield-node-B_Paste.gbp, magfield-node-B_Silkscreen.gbo, magfield-node-Edge_Cuts.gm1, magfield-node-F_Courtyard.gbr]
2026-10-30 Add charge hub board PCB (4-layer, WIP)
    [magfield-hub.kicad_pcb]
2026-10-30 Add charge hub gerbers (part 1)
    [magfield-hub-F_Fab.gbr]
2026-10-30 Add charge hub gerbers (part 2)
    [magfield-hub-B_Cu.gbl, magfield-hub-F_Cu.gtl]
2026-10-30 Add charge hub gerbers (part 3)
    [magfield-hub.kicad_sch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]
2026-10-30 Node: add M2 mounting holes (NW-SE); add charge hub schematic, DESIGN, BOM/CPL and READMEs
    [hub-bom-jlcpcb.csv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]
2026-10-30 Add node renders with M2 mounting holes
2026-11-01 Charge hub: add U2 revision attempt as WIP file; main board unchanged (routed70)
    [magfield-hub-u2rev19-WIP.kicad_pcb]
